joengineer656/test-claude-in-mechanical-design/DECISIONS.md

# Client Decisions Log — ALL ENGINEERS MUST READ BEFORE WORK

| Date | From | Decision / instruction |
|---|---|---|
| 2026-11-04 | Client | Wheel-legged, 2 wheels, Ascento-style legs with springs ("snappers") for jumping. |
| 2026-11-04 | Client | Model in SolidCraft. Everything 3D printed. Wheels PLA/ABS, tyre TPU with plug-and-play holes/slots (Image #1 style). |
| 2026-11-04 | Client | Design 3D-printed gearboxes for the 8308 motors. |
| 2026-11-04 | Client | Centre of mass in the middle. Room for all BOM parts. |
| 2026-11-04 | Client | Full plan + project structure before building anything. |
| 2026-11-04 | Client | Batteries: 2×3S in **series = 6S (~22.2 V)**. Check that the MKS XDrive Mini accepts 6S. |
| 2026-11-04 | Client | Wheel motors **in the wheel hub** with a planetary gearbox inside the wheel. |
| 2026-11-04 | Client | Printer: **Bambu Lab A1, 256×256×256 mm**. Split any part larger than ~250 mm. |
| 2026-11-04 | Client | Lidar: **LD19 / LD06** (~47 g). |
| 2026-11-04 | Client | **Gate A: conditional approval for P1 calculations only. NO detailed CAD until client approves P1 results (Gate B).** |
| 2026-11-04 | Client | Added Robotics & Control Engineer (balance, IMU, encoders, state estimation, motor control, jump coordination) and Electrical Engineer (battery safety, driver compatibility, power distribution, protection). |
| 2026-11-04 | Client | KV 90 is NOT confirmed. Verify 8308 specs from sources. Compare wheel ratios 4:1, 5:1, 6:1 on real data. |
| 2026-11-04 | Client | Calculate hip torque, spring rate, preload, max compression, landing loads. Study hub-motor drawbacks (unsprung mass, wheel inertia). |
| 2026-11-04 | Client | 3.95 kg budget rejected as too close to 4 kg — rework with margin. Study printed planetary gear strength; use metal gears/shafts where needed. |
| 2026-11-04 | Client | Verify MKS XDrive Mini vs 6S full charge (25.2 V) and regenerative braking. Add balancing simulation + staged prototype tests before jumps. |
| 2026-11-04 | Client | Every engineer: document assumptions, calculations, sources, open questions; record any change to design assumptions in their report. |
| 2026-11-04 | Client | Motors: **buy Eaglepower 8308 KV130** for the hips (KV90 rejected — too slow on ODrive v3.6 at 6S). |
| 2026-11-04 | Client | Mass: **use lighter (~170 g class) wheel motors**; 8308 KV130 stays on the hips only. Target ≤3.6 kg. Wheel motor to be selected in P1 (Theory + Electrical + BOM). |
| 2026-11-04 | Client | Battery: **one 6S 2200 mAh 50C pack** (replaces 2×3S in series). |
| 2026-11-04 | Client | Hip gears in **PAHT-CF** on the Bambu A1 with a hardened nozzle + filament dryer; print a test gear coupon first. |
| 2026-11-04 | Client | **CAD engineers: for bought parts (motors, drivers, sensors, Pi, lidar, camera, bearings, battery) search the web for ready 3D models (GrabCAD, manufacturer sites, McMaster, Thingiverse/Printables) and use them in the assembly instead of drawing them.** Store them in `cad/vendor/`, with each link and version in `cad/vendor/SOURCES.md`. Check every model's key dimensions against the datasheet. |
| 2026-11-04 | Client | **Mass: 4.31 kg accepted** ("not a problem"). Requirement changed from 3–4 kg to ≤4.31 kg. |
| 2026-11-04 | Client | Keep **8 J springs**. Wheel hubs in **PETG** (PLA rejected for heat). |
| 2026-11-04 | Client | **Gate B approved: P1 frozen (docs/design_targets.md rev 2). Client: "approved and start continue to end this project" — proceed P2 → release without stopping at Gate C; report progress.** |
| 2026-11-04 | Manager | O13 result: end stop changed to ≈10 kN/m TPU, engaging at 130 mm hip height, ≥30 mm travel; 40 A hip push-off mandatory; wheel gear ultimate 9 Nm. (design_targets rev 2.1) |
| 2026-11-04 | Manager | P2 layout accepted (docs/layout.md). Depth ≤300 mm applies at nominal stance; 321 mm at full crouch accepted (requirement says "around"). |
| 2026-11-04 | Manager | Layout mass 4.37 kg (+58 g, inside ±15 % estimate): P3 designers must recover it with the low-cost cuts (tyre lattice, thin covers, fewer fasteners). Target stays ≤4.31 kg. |
| 2026-11-04 | Manager | All 4 drivers on Al plates in the body; hips also use remote AS5047P/AS5048A encoder breakouts. Battery stands upright at the rear wall (CoM). Hub: Al stator carrier = hollow fixed axle, Ø14 bore, encoder on the motor axis (O11 closed). |
| 2026-11-04 | Manager | Spring stroke only 42 mm in the layout → Theory re-fits the spring (rate/crank) for 8 J. |
| 2026-11-04 | Manager | Spring re-fit: 2.7 N/mm, 2 mm music wire, OD 13, free ≈110 mm, 8 N preload, 122 N max at 42 mm; body anchor moved 49 mm outward to (94.1, 71.2) mm from the hip. **Stores 5.5 J, not the client's 8 J** (the anchor span limits it); jump 23.5 cm real at 19.8 V. Pending client objection — 8 J needs a larger layout change. Anchor design load 180 N. |
| 2026-11-04 | Manager | P3a hip gearbox accepted with conditions (docs/parts/hip_gearbox.md). CAD mass 413–435 g/side (+~0.3 kg robot, +96 g Al plates) vs 271 g budget (O10). Manager approves recovery options 1–5 (→ ≈330 g/side). Frozen gear set kept. Housing Ø122 → body gets local bulges (~4 mm front, 1–4 mm top); thigh plane +12 mm outboard. **Projected robot mass ≈4.5–4.6 kg — above the client's 4.31 kg; to be reported to the client.** |
| 2026-11-04 | Manager | Fuse: **50 A** slow-blow (electrical rev 2 follow-up; supersedes 60 A). Battery rail trim is 0…+20 mm (CoM moves ~1.7 mm per 20 mm). Spring anchors need outrigger arms on the body (anchor 37 mm ahead of the front wall, 11 mm above the top). Hip posts 4 × 49 mm from the Al plate to the side plate. |
| 2026-11-04 | Manager | **CAD method: parallel engineers use `solidcraft-cli run script.json --save part.solidcraft` (headless, own file, own process) — NOT the shared MCP/app session.** Only the final assembly uses the app. |
| 2026-11-04 | Manager | Wheel spec accepted (docs/parts/wheel_spec.md). O-W1: wheel outer face at Y 151 (+1 mm) accepted — overall width stays ≤300 only if track is reduced 2 mm: CAD engineer adjusts track to keep ≤300. O-W2: 6806 pair SF 1.3 one-shot static accepted for rare fault, Structural to confirm. O-W3: fin area 60 cm² accepted for ~2 A real duty (continuous limit lower than 7 A) — Thermal to re-check. Wheel module ≈600 g vs 536 g: apply the spec's cuts. |
| 2026-11-04 | Manager | **Structural review of hip gearbox FAILED the single 6806** (fault landing 2.13 kN radial + 22 Nm moment: ball SF 0.78, tilt ≈4.8°). **Decision: second hip output bearing on an outboard stub at y≈108 (arch), ≥21 mm spacing with the thigh plane between the two bearings** (each ≈1.1 kN, SF 2.7). Thigh hex socket must be PAHT-CF or steel-lined (PETG SF 0.78). Skirt needs stiffening (SF 1.41 → ≥1.5). Body side plate needs a seat to take the radial load from the Al plate (PETG SF 0.8 otherwise). M3 washers mandatory on stack bolts. New load case: lateral slide landing 1.0–1.7 kN axial (cover lip SF 1.1 → strengthen). M4 insert pull-out in PAHT-CF needs a test coupon. Load cases S1–S13 in docs/analysis/structural.md §3 apply to legs, hub, body. |
| 2026-11-04 | Client | **Weight and diameter increases are NOT a problem. Priority = finish the project. Do not stall on mass/size limits; choose the stronger/simpler design and just report the final numbers.** (Mass limit and 300 mm width become soft targets; no more client questions about mass.) |
| 2026-11-04 | Manager | Leg spec accepted (docs/parts/leg_spec.md) with fixes: shank gets a 2 mm Al plate (SF 1.12 → 1.9); knee/links built as double-plate clevis (symmetric) to avoid the ~48 Nm offset couple; spring-to-B-pin clearance −0.3 mm at crouch must be fixed (offset the spring or widen the B pin spacing, parameters may move ±10 mm); pins Ø8 steel with bronze bushings; spring anchor on a tower bracket; depth 302 / 323 mm accepted (soft limit). |
| 2026-11-05 | Manager | Wheel CAD accepted (docs/parts/wheel.md). Spur gears (herringbone loft hangs the kernel; zero tooth overlap verified); chevron tread → straight grooves; width ≈301 mm; wheel module ≈601 g printed. Open: neck wall 1.4 mm (must be thickened to ≥2.5 mm), outboard bearing retention (add a retaining ring/cap). |
| 2026-11-05 | Manager | Body CAD accepted (docs/parts/body.md): 611 g solid (≈450–500 g sliced). Hip bulge Ø140, front reach x 99.6. Battery raised 9.4 mm, Pi moved 20 mm forward. Charge port in the lid, XT60 charge lead bypasses fuse and switch BY DESIGN — must be a keyed charge-only connector (XT60 with a protective cap), never used as a load connector; Electrical to confirm. Open: hip posts vs skirt ears (hip gearbox rotates ears), ear relief in hip seat, outboard arch bracket (add after hip gearbox final envelope). |
| 2026-11-05 | Manager | Wheel fixes done: neck Ø38 (wall 3.4 mm), shank foot hole Ø38.2 (leg must match), circlip groove for the outboard bearing race. Module ≈606 g printed. |
| 2026-11-05 | Manager | Leg CAD accepted with open items (docs/parts/leg.md): ≈945 g/leg solid (1.7–1.9 kg both legs vs 254 g in layout). B pin moved to (46,30); spring axis y 110. **Wheel (R85) hits hip housing/arch below hip height ≈137 mm → minimum hip height raised to 140 mm (end stop engages ≥140), stroke becomes 140–289 mm.** B-pin 2 kN path (arch/posts/beam) undersized (SF 1.3) → box beam or tie into body frame (needs fix). Thigh angle shifted (nominal −33°): check gearbox homing tab. **Mass now far above the layout; function (20 cm jump, 12 km/h) must be re-verified at the real mass — client accepted weight growth, not loss of function.** |
| 2026-11-05 | Manager | **Actual CAD mass roll-up: 6.86 kg solid, ≈6.4 kg sliced (range 6.0–6.9 kg) vs 4.31 kg accepted. Unsprung 0.84–0.93 kg/side. CoM ≈ +11 mm forward (approx).** Theory must re-verify 20 cm jump, 12 km/h and balance at 6.4 kg with hip height ≥140 mm. |
| 2026-11-05 | Gearbox CAD | Rev 1: 2nd 6806 on arch (bearings 21 mm apart, thigh plane y 94-103, arch y 104-116 on housing ear at world 105 deg); skirt windows 10x10 + 6 ribs; cover lip 2 mm; ears rotated to world 15/75/105/165/195 deg (clear of body posts); thigh clamp = 1 central M4 insert (3 face inserts removed); skirt top lip dropped; mass ~500 g/side + 80 g plate; O10, OQ-2 closed; insert pull-out coupon open. |
| 2026-11-05 | Manager | Hip gearbox rev 1 accepted (docs/parts/hip_gearbox.md): bearings at y 87.5 / 108.5; thigh plane y 94–103; arch y 104–116 (X 1.6–51.5, Z 256.5–351.6); ears at world 15/75/105/165/195° (≥30° from body posts, max r 66.8, x 94.8 < 99.6); ≈500 g/side + 80 g Al plate. Skirt top lip dropped, thigh clamp = one central M4 insert. **All four part CADs done → full assembly in the SolidCraft app next.** |
| 2026-11-05 | Manager | **Theory re-run at 6.0 kg (partial): 20 cm jump FAILS** (16.1 cm real with springs at 19.8 V, 19.1 cm at 22.2 V); stiffer springs do not rescue it (4.1 N/mm → 17.1 cm). **Hip ratio 6:1 passes (21.6 cm).** Fault landing (motors off) 30 Nm vs 16 Nm hip gearbox limit also FAILS. 12 km/h and balance PASS. Standing needs 3.8 Nm/leg; single-leg climb 8.5 Nm/leg (> 5.7 Nm cont, brief use only). Manager direction: Materials designs a 6:1 compound set that fits the existing hip housing; mass trim of the legs to follow if Theory's 6.4/6.9 kg results still fail. |
| 2026-11-05 | Manager | **Theory final re-run (CAD mass 6.0–6.9 kg): 20 cm jump fails ≈16 cm real at 19.8 V at EVERY mass tested (4.4–7.0 kg) — mass is NOT the cause; the cause is the raised minimum hip height (140 mm, stroke 150 mm) with speed-limited 8:1 hips.** (Correction of the manager's earlier remark that cutting leg mass helps the jump.) Fix: **hip gearbox 6:1** → 21.4 cm (6.0 kg 21.6, 6.9 kg 20.9), hip peak 13 Nm < 16 Nm. Also FAIL at 6.4 kg: controlled landing 16.7 Nm (limit 16), one-wheel-first 24 Nm, motors-off 29 Nm, knee pin 2.6 kN vs 2.0 kN design load. PASS: 12 km/h (19.2 km/h), balance (41–45° tilt), standing 4.1 Nm/leg, single-leg climb 5.0 Nm (5.8 Nm at 6.9 kg, marginal). Needed: torque limiter/slip or compliant stop for motors-off landings, stronger knee-pin load path. |
| 2026-11-05 | Manager | **Hip gearbox changes to 6:1** (materials_gears.md 'Hip 6:1 option'): sun 28 T m1.0 spur b15.5 (x −0.146); planet big step 40 T m1.0 spur b14 (x −0.097), tip r 54.7 mm; ring 63 T m1.5, small step 18 T m1.5, carriers, pins, bearings, housing UNCHANGED. Centre distance 33.75 both stages. Sun SF 1.78, ring mesh 2.26 at 20 Nm / 50 °C. Hip peak 13 Nm at 40 A. Fault landing ≈17 Nm vs 20 Nm design torque (capacity 36 Nm, SF 2.1): **accepted — design torque 20 Nm governs (theory's 16 Nm was a conservative target)**, still add the compliant stop. Design targets updated: hip 6:1. |
| 2026-11-05 | Gearbox CAD | 6:1 implemented in CAD: sun 28T / planet big 40T m1.0 (x -0.146/-0.097); planets 2,3 spun on their pins by 120 and 60 deg (Zs/3 not integer, raster check: 0 interference, min gap 0.056 mm); swept R 54.7; -13 g/side (~484 g/side + 80 g plate). STL/STEP/exploded updated. |
| 2026-11-05 | Manager | Hip 6:1 in CAD (hip_gearbox.md rev 1.1): ≈484 g/side + 80 g plate, planet swept R 54.7 vs housing inner R 58.5. **Assembly note: Zs=28 not divisible by 3 → planets 2 and 3 must be spun on their pins by 120° and 60° (mark the planets; same part, different assembly orientation).** 2D raster: 0 interference; planet-sun flank gap ≥0.056 mm (verify by test print). hip_gearbox.step replaced → assembly must use the new file. |

## 2026-11-05 Assembly review decisions (Manager) — see docs/assembly.md section 6
| # | Decision |
|---|---|
| A1 | Assembly result: 303.4×302×403 mm, 6.96 kg solid / 6.33 sliced, CoM +22 mm ahead of axle (FAIL, target ±5), 17 mismatches M1–M17. |
| A2 | M1: the LEG's outer bearing/arch plate stays; the hip gearbox deletes bearing 2, Ø30 journal extension and HG_Arch bar/ring (keeps hex + clamp insert). Structural re-checks SF. |
| A3 | M8: minimum hip height stays 140 (jump); BODY notches side plates/tray around the axle path (option b). |
| A4 | CoM: Leg+Theory re-fit the 4-bar nominal pose so the hip is 10–15 mm ahead of the axle (not 37). Interim: controller pitch trim. Client allows weight/size growth. |
| A5 | M3: sleeve inner 26.3 A/F; gearbox homing tab/stop moved to -33.19° (thigh angle changes with A4 → use final angle). M4 +1 mm thigh plane; M10–M12 +0.5–1 mm spacings. |
| A6 | M7: the body spring dowel is deleted; the 180 N path = leg arch plate + posts + beam, tied to the body frame; Structural decides box beam. |
| A7 | M14 LD19 = Ø54×35, mast plate Ø60. M13 resistors/Pi/camera moved per assembly.md. |
| A-GB | Hip gearbox (2026-11-05, rev 3) | M1/M3/M4 done in CAD: bearing 2, Ø30 journal ext. and HG_Arch deleted (clamp insert hole now z 55-65 in the hex); homing tab at 213.19 deg local (thigh -33.19; re-check vs leg_interfaces_rev2.md, not yet written); cover boss trimmed to y 92 (lip now 1 mm). Mass 434 g/side (514 with plate). M6 ear rotation not done (Body arm decision pending; needs Ring/Cover/Skirt rebuild). **Structural: the outer leg bearing alone does not relieve bearing 1 (thigh load enters at the hex 11.5 mm from it); need a short (3-4 mm) steel sleeve at the inboard end of the hub with the rest relieved >= 0.5 mm: then LC-A/B/C pass, LC-D marginal (ball 1.14, seat 1.42). 1 mm cover lip fails at 1.7 kN axial (0.73): keep a 2 mm lip (thigh +1 mm instead of the trim) or add a circlip.** |
| A8 | Leg rev 2 (Manager-accepted): B pin (39,31), anchor (97.4,70.9); nominal thigh angle -24.26°; hip 10.6 mm ahead of axle; CoM +2.0 mm solid / +0.9 mm sliced (target ±5, PASS). Axle is 26 mm further forward than rev 1 → Body re-derives axle notch. |
| A9 | Spring changed to 3.5 N/mm, 15 N preload, peak 169 N, 4.0 J/leg (8.1 J both = the client's 8 J request, met). Jump 20.2 cm real at 6.4 kg/19.8 V (19.7 at 6.9 kg: marginal). Materials/Electrical must confirm wire stress (~740 of ~900 MPa) and order the spring. |
| A10 | Thigh sleeve 4 mm long (y 94–98), pocket relieved; thigh plane y 94–104; 6061 box beam 40×8.5×2 tied to body with 2×M5; leg exports now world coordinates (left), right = true mirror. |
| A11 | Client: "skip the thermal test" → P4 thermal re-review at the final CAD is skipped. Existing thermal.md design rules (finned axle, fan, vents, NTC per motor) stay as is, unverified at the new mass. |
| A12 | Final sim (2D/1D, not hardware): balance + 12 km/h PASS at 6.4/6.9 kg; jump 21.7/21.2 cm from 22.2 V rest, 19.9/19.5 from 20.5 V → jump gate rest voltage ≥21.5 V (22.0 aged). Controller must add integrator/pitch trim and IMU zero at CoM line. Spring spec: Ø2.00 A228, OD 13, ~34 active coils, 3.5 N/mm, 15±3 N, free 116 mm, reduced closed hooks ID 6.5, stress-relieved; SF 1.19 (thin) → order 6, replace after 500 jumps; fallback Cr-Si wire. Test plan rev 6 in control.md §3.7. |
| A13 | Structural Rev 2 formal check: all loaded leg parts must be PAHT-CF (PETG fails). Manager accepts changes C1–C11 (structural.md): Al shank plate 3→6 mm; C pad → S355 Ø21 stand-off Ø36 flange 4×M5; thigh boss R17→R20 + DU-type bush; Ø38×4 round steel sleeve; posts Ø16→Ø18; beam foot 47×32 with 4×M5 through-bolts + backing plate, beam height 12; hip bearing 1 6806→6906; body post base seat y 40 + D16.4×10 collar; knee pin capped 2.0 kN by compliant stop. Lateral-slide fault case (LC-D) accepted as abuse case (no fracture required). FEA of shank + arch plate still to do before release. |
| A14 | Client: "after both finished stop the project until I told you" → when the Body/Gearbox and Assembly rev 2 agents finish, NO further work or agents until the client says continue. Next planned step then: assembly rev 3 with Leg 2b + Body/Gearbox structural changes, Theory CoM/jump re-run, FEA, release. |
| A15 | Assembly rev 1 (rev 2 parts, before Leg 2b/structural changes): 13 PASS, M3 + M13 FAIL, CoM +1.6/+0.4 mm PASS, size 308.9×302×403. Manager decision: IMU rule relaxed to ≥30 mm from motor (ICM-42688 has no magnetometer; ±30 mm of CoM kept). Fix list queued (not started, project paused per A14): sleeve/pocket -5.8°; Pi plate notch 25×4; camera +1.5 mm; extension stop ≥20° further out; front cover lip widen hip notch; M16 confirm. |
| A16 | Client: "stop everything" → all agents stopped, project paused until the client says continue. |
