joengineer656/test-claude-in-mechanical-design/51fNBSpzq5L.jpg

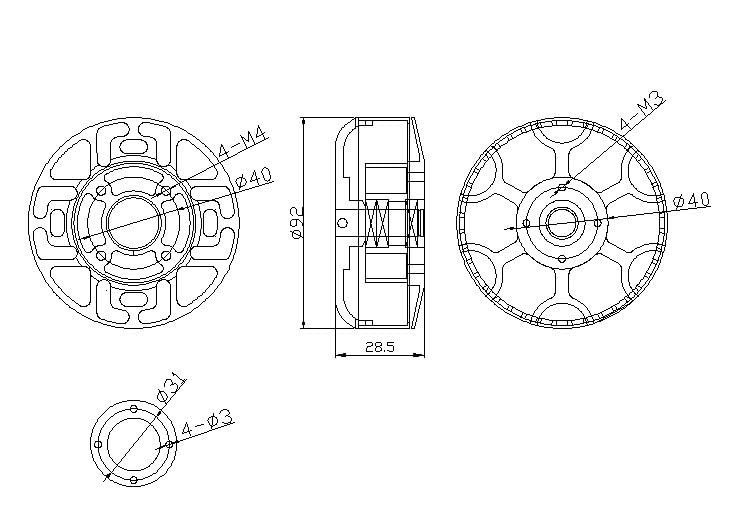
51fNBSpzq5L.jpg
