joengineer656/test-claude-in-mechanical-design/docs/screenshots/body_left.png

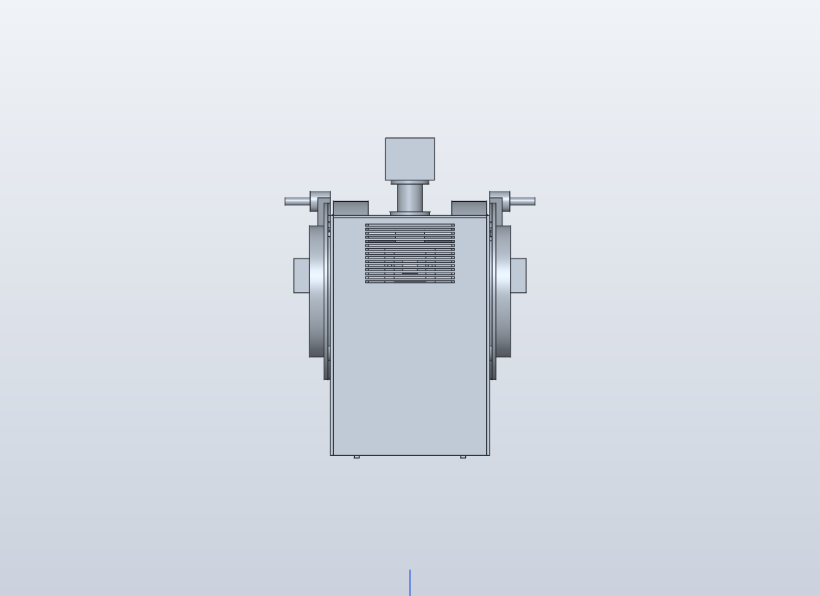
docs/screenshots/body_left.png
