joengineer656/test-claude-in-mechanical-design/docs/screenshots/body_top.png

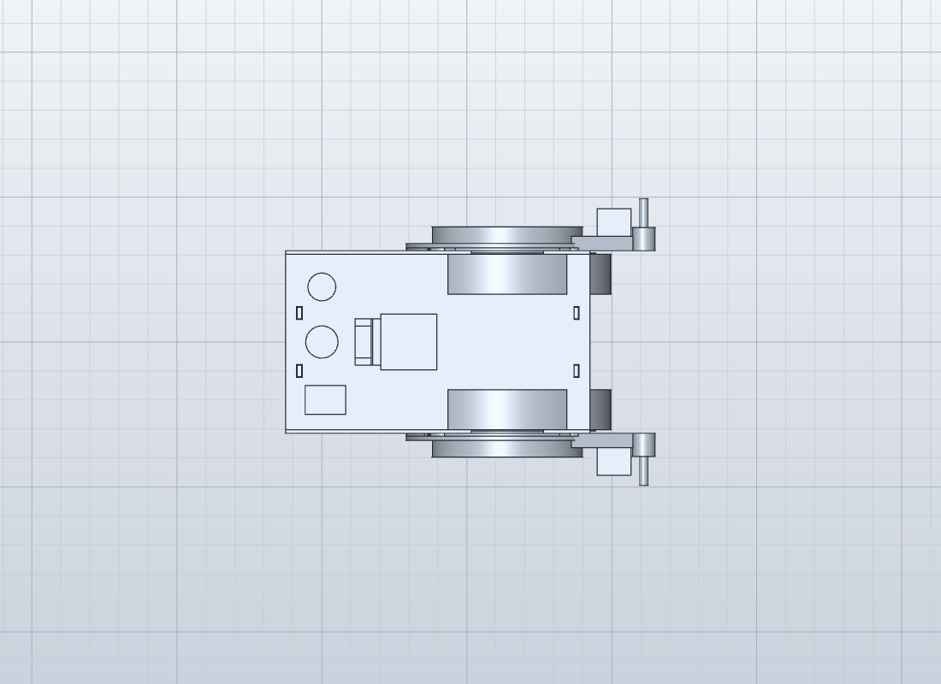
docs/screenshots/body_top.png
