joengineer656/test-claude-in-mechanical-design/docs/screenshots/hip_gearbox_arch.png

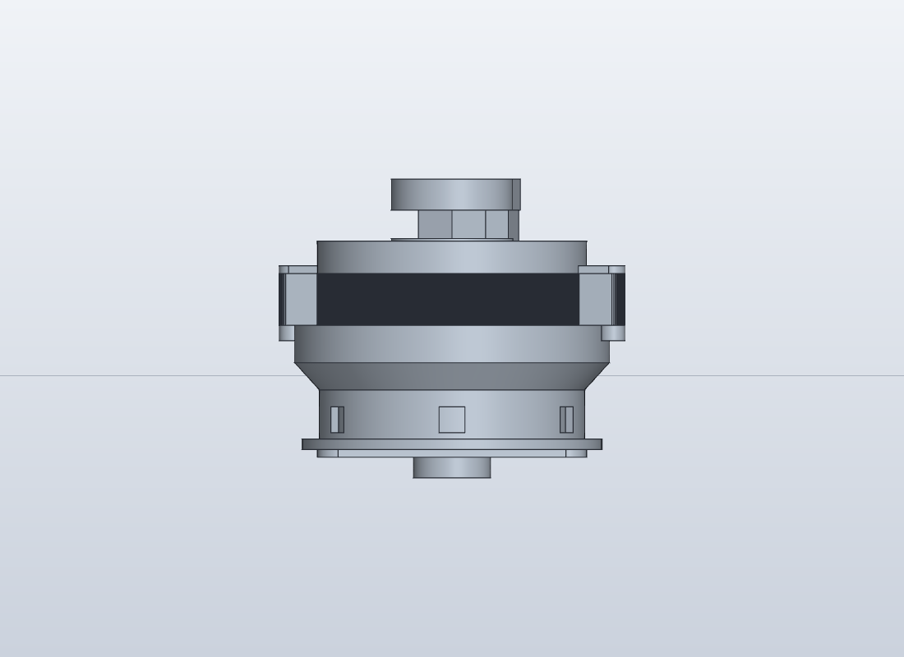
docs/screenshots/hip_gearbox_arch.png
