joengineer656/test-claude-in-mechanical-design/docs/screenshots/hip_gearbox_ring_stage_z30.png

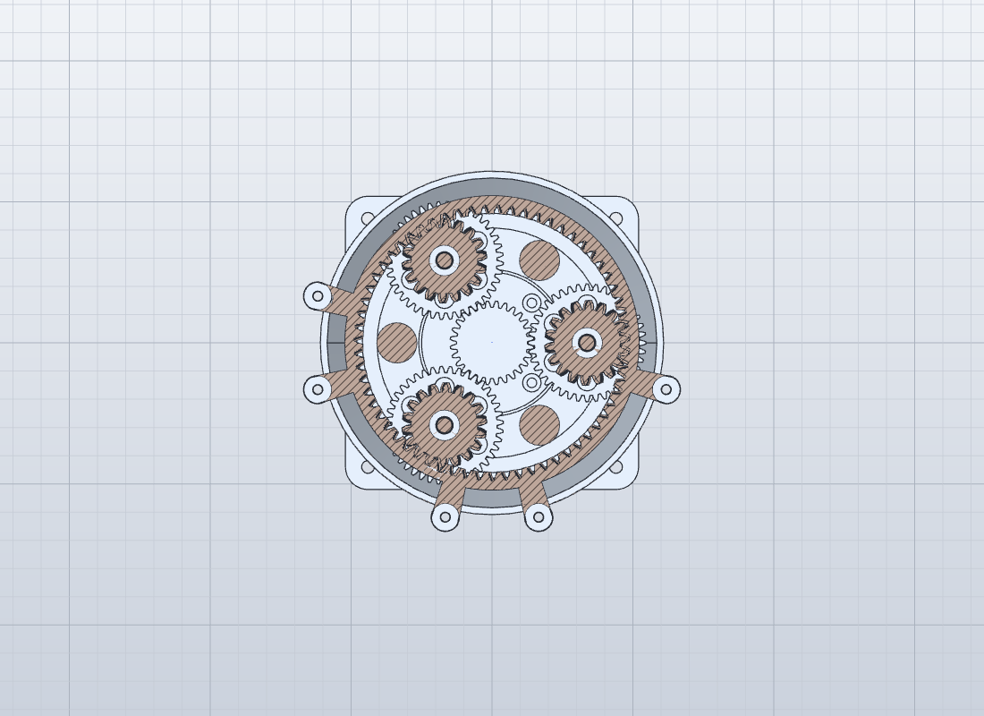
docs/screenshots/hip_gearbox_ring_stage_z30.png
