joengineer656/test-claude-in-mechanical-design/docs/screenshots/leg_101_iso.png

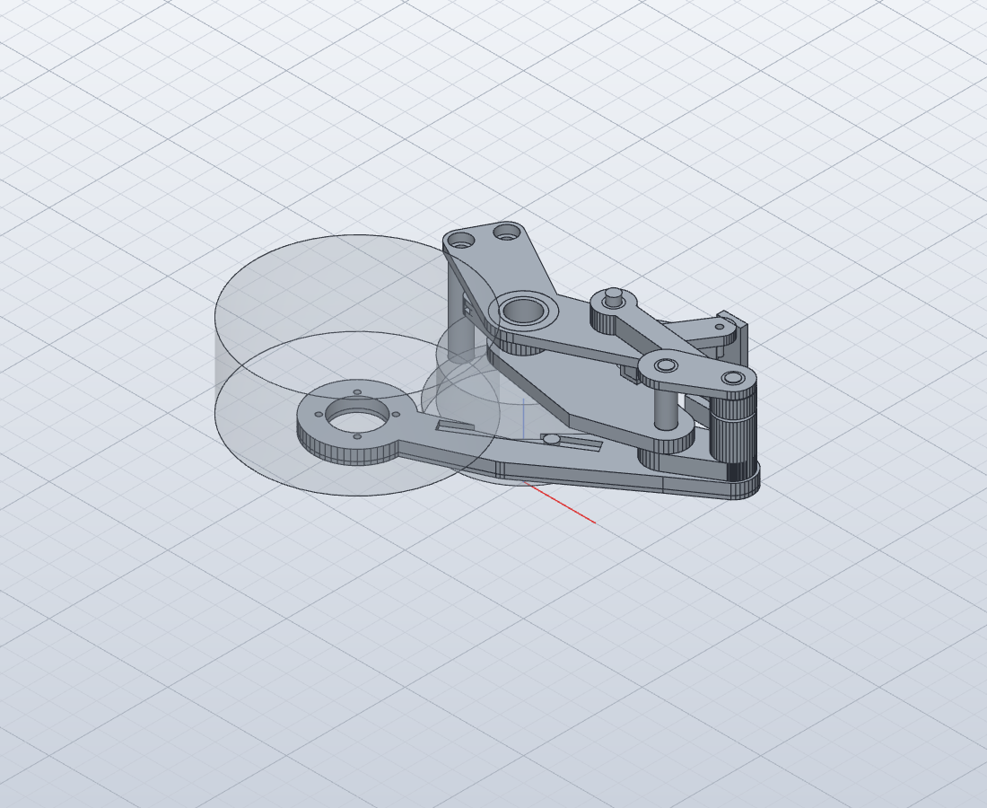
docs/screenshots/leg_101_iso.png
