joengineer656/test-claude-in-mechanical-design/docs/screenshots/leg_101_plane.png

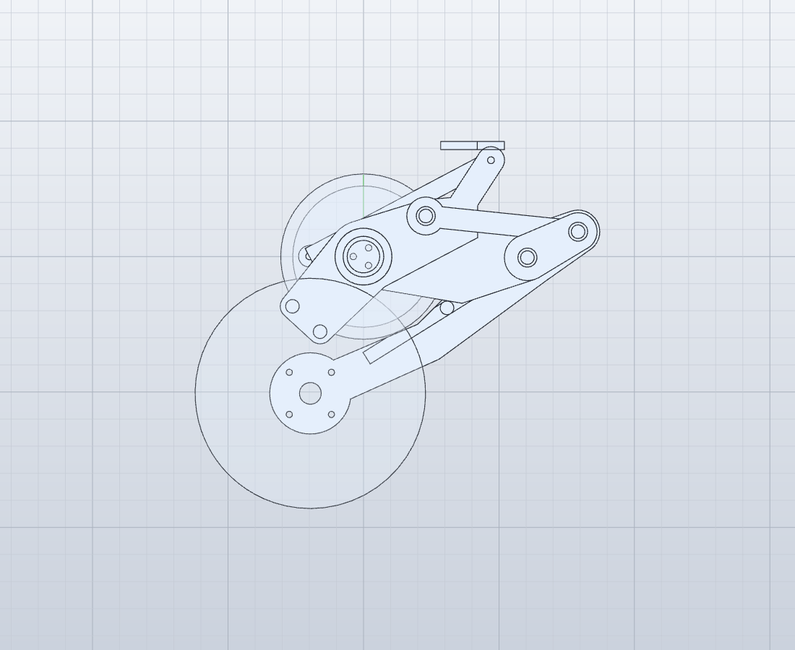
docs/screenshots/leg_101_plane.png
