joengineer656/test-claude-in-mechanical-design/docs/screenshots/leg_195_plane.png

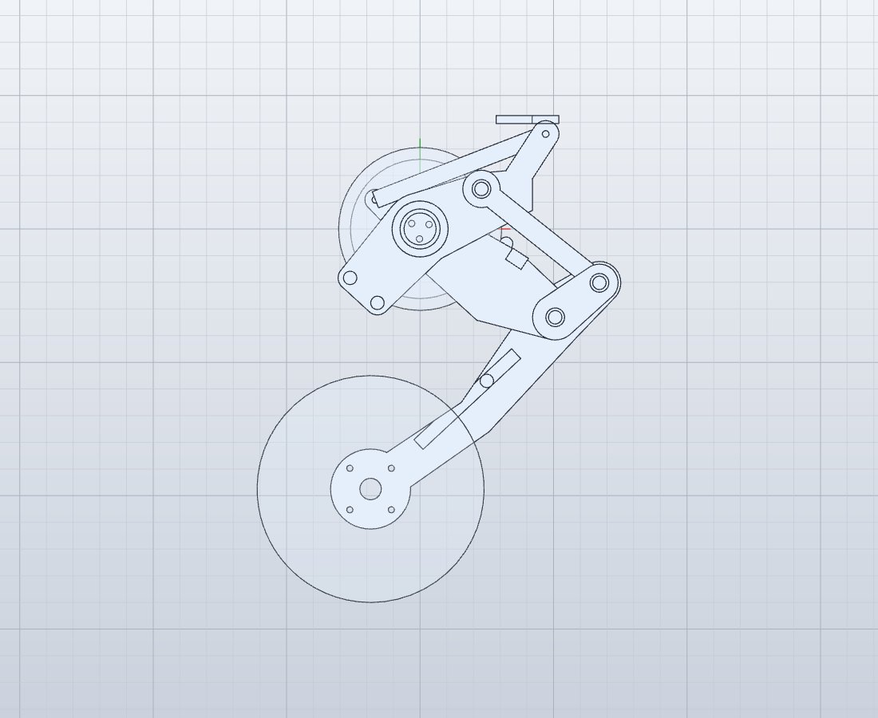
docs/screenshots/leg_195_plane.png
