joengineer656/test-claude-in-mechanical-design/docs/screenshots/master_layout_front.png

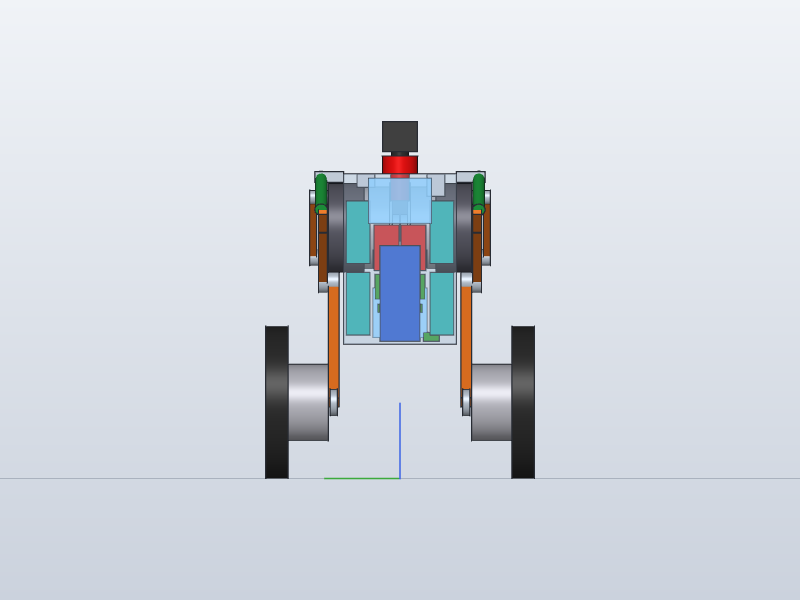
docs/screenshots/master_layout_front.png
