joengineer656/test-claude-in-mechanical-design/docs/screenshots/master_layout_side_crouch.png

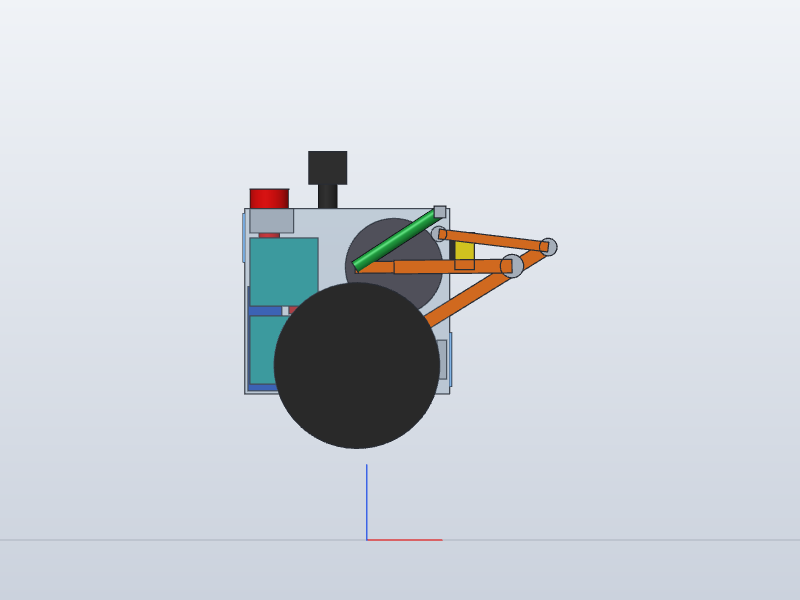
docs/screenshots/master_layout_side_crouch.png
