joengineer656/test-claude-in-mechanical-design/docs/screenshots/wheel_gears_z56.png

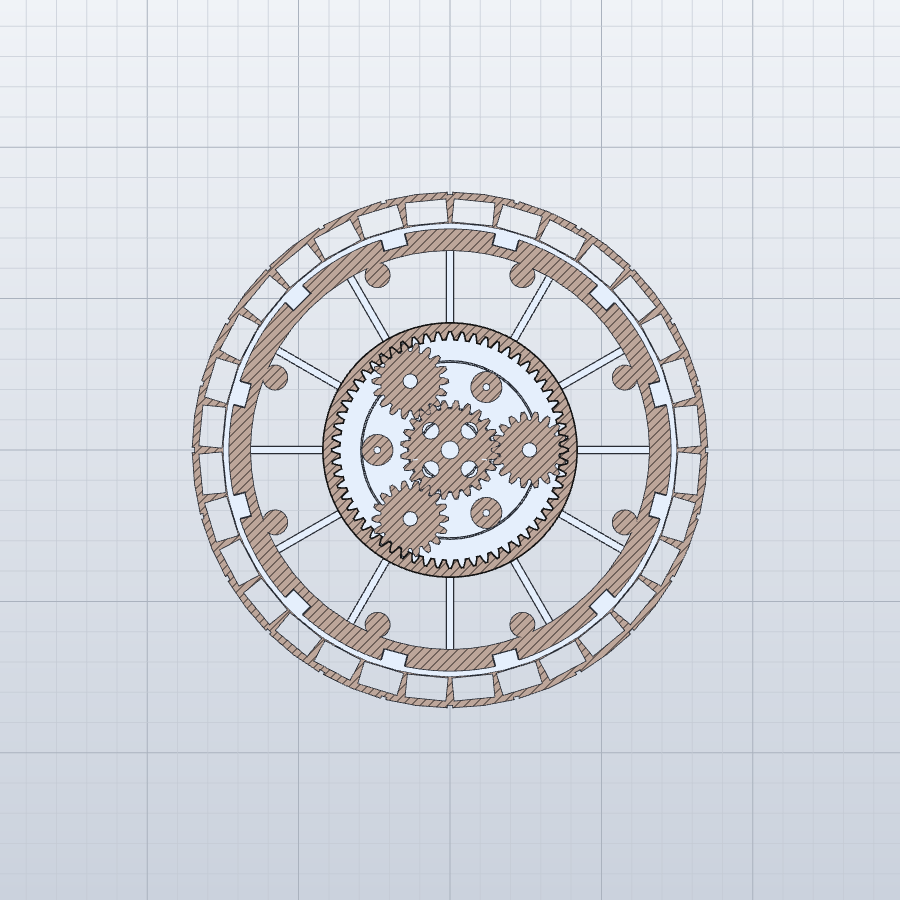
docs/screenshots/wheel_gears_z56.png
