joengineer656/test-claude-in-mechanical-design/exports/step/leg_plate.step

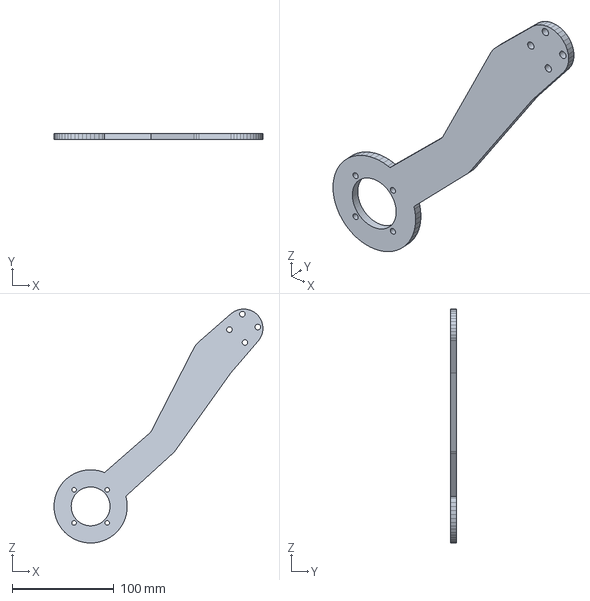
[picture p25: CAD file, 2026-11-05]
exports/step/leg_plate.step
205.5 x 6.00 x 230.1 mm
