joengineer656/test-claude-in-mechanical-design/exports/stl/body/B7a_PiDeck.stl

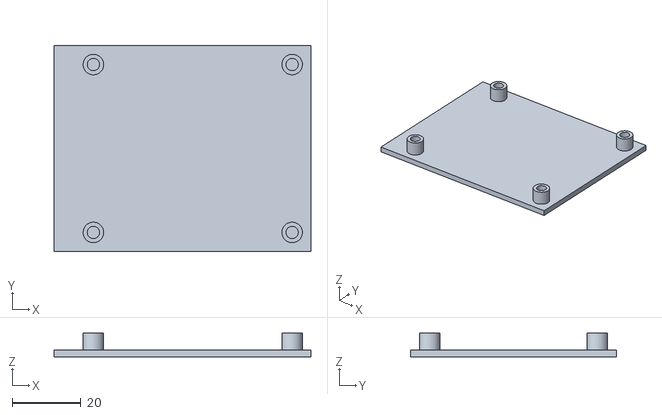
[picture p26: CAD file, 2026-11-05]
exports/stl/body/B7a_PiDeck.stl
75.0 x 60.0 x 7.00
