joengineer656/test-claude-in-mechanical-design/exports/stl/hip_gearbox/HG_Skirt_L.stl

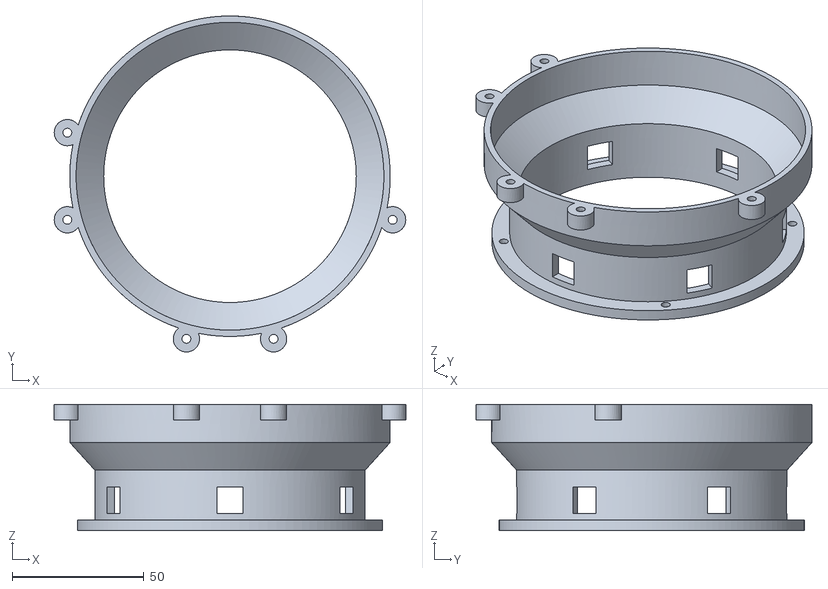
[picture p27: CAD file, 2026-11-05]
exports/stl/hip_gearbox/HG_Skirt_L.stl
133.6 x 127.7 x 48.0
