joengineer656/test-claude-in-mechanical-design/exports/stl/leg/posts.stl

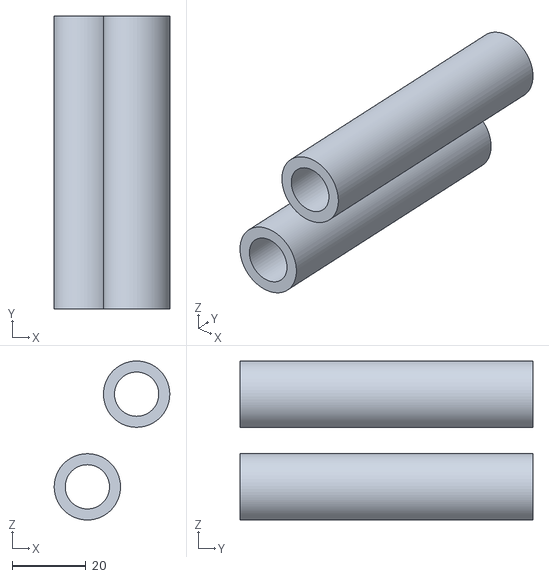
[picture p28: CAD file, 2026-11-05]
exports/stl/leg/posts.stl
31.4 x 79.5 x 43.1
