joengineer656/test-claude-in-mechanical-design/exports/stl/wheel/bought.stl

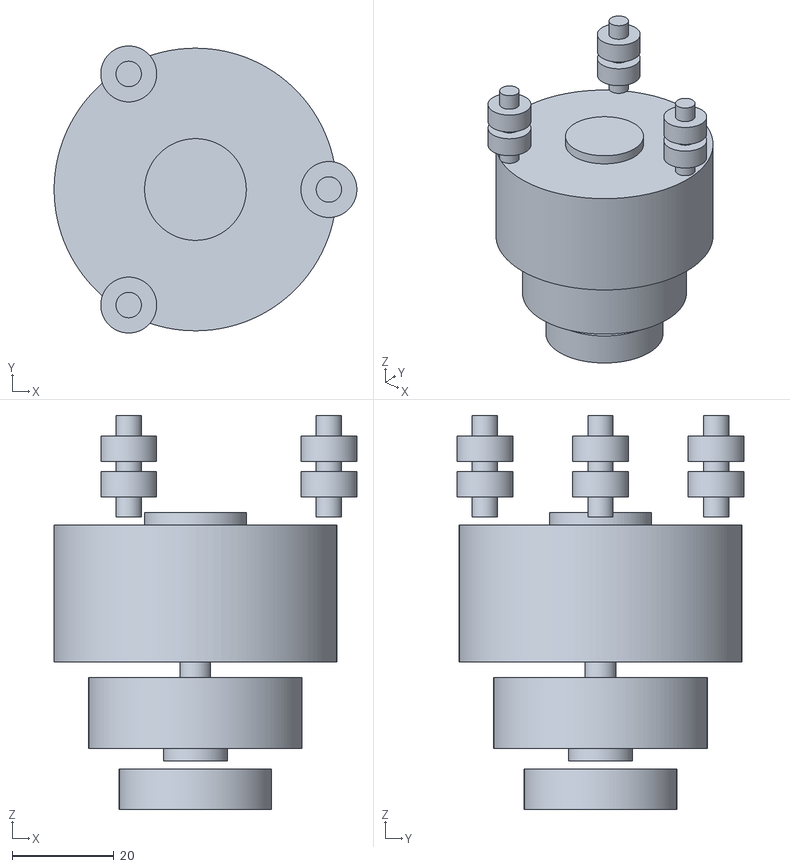
[picture p29: CAD file, 2026-11-05]
exports/stl/wheel/bought.stl
59.5 x 56.5 x 77.5
