joengineer656/test-claude-in-mechanical-design/exports/step/body.step

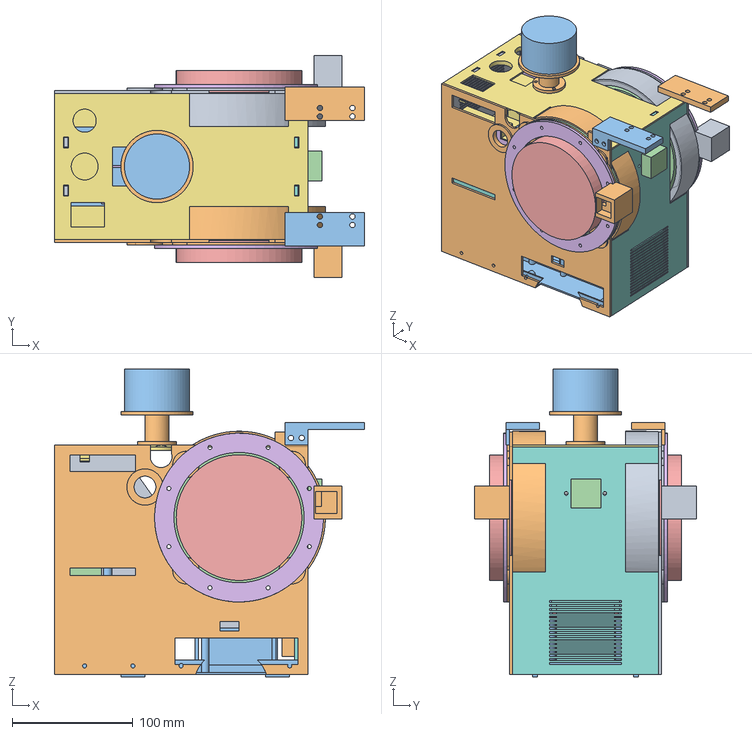
[picture p30: CAD file, 2026-11-05]
exports/step/body.step
257.0 x 184.0 x 255.0 mm
