joengineer656/test-claude-in-mechanical-design/exports/stl/body/B1T_Tie_R.stl

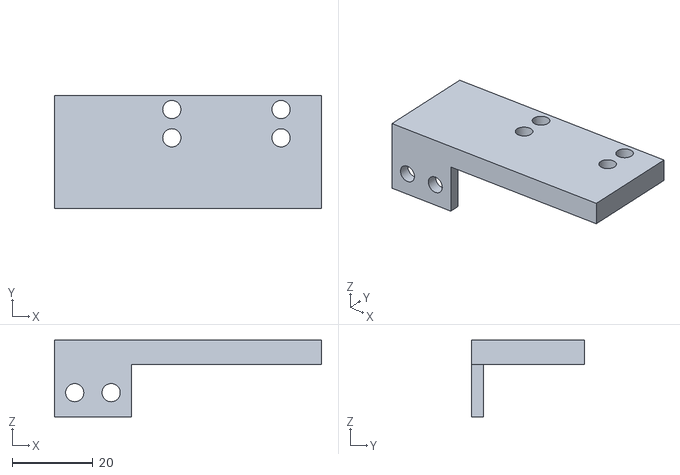
[picture p31: CAD file, 2026-11-05]
exports/stl/body/B1T_Tie_R.stl
66.0 x 28.0 x 19.0
