joengineer656/test-claude-in-mechanical-design/exports/stl/hip_gearbox/HG_Planet_x3.stl

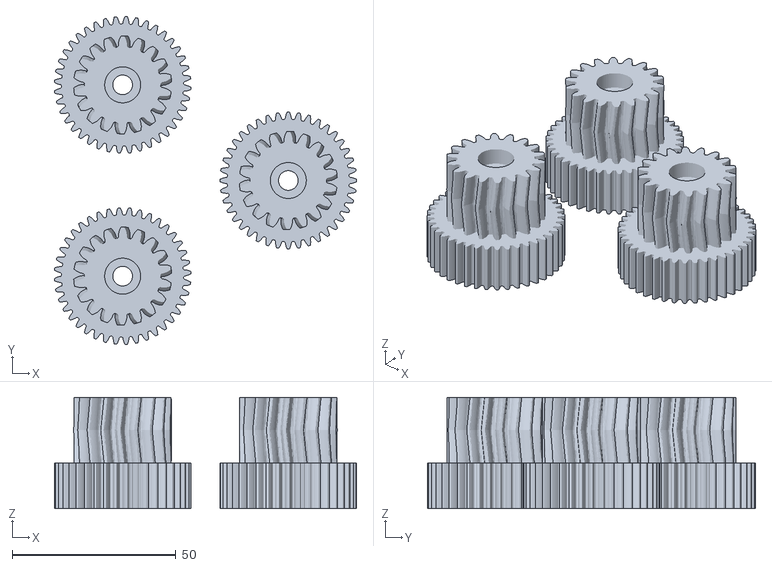
[picture p32: CAD file, 2026-11-05]
exports/stl/hip_gearbox/HG_Planet_x3.stl
92.4 x 100.2 x 34.0
