joengineer656/test-claude-in-mechanical-design/exports/stl/leg/thigh.stl

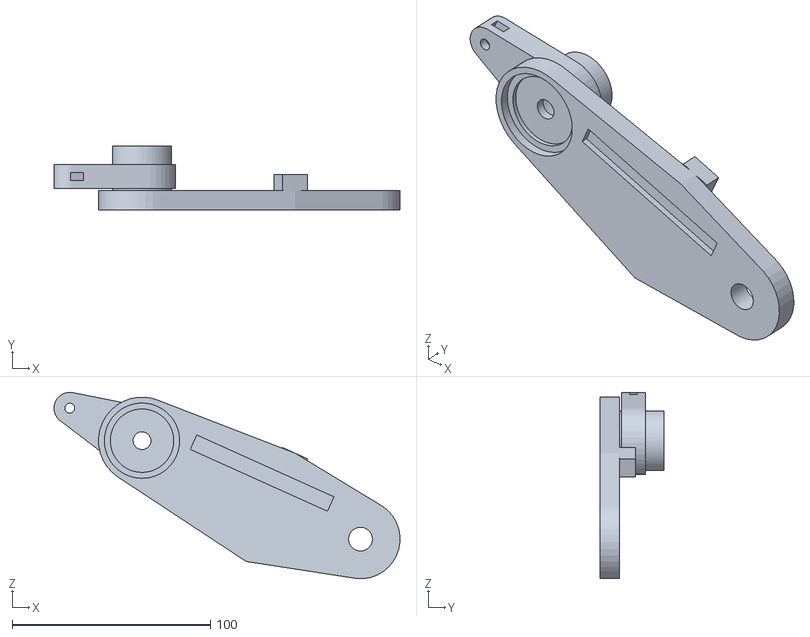
[picture p33: CAD file, 2026-11-05]
exports/stl/leg/thigh.stl
174.7 x 32.5 x 94.1
