joengineer656/test-claude-in-mechanical-design/exports/stl/wheel/carrierB.stl

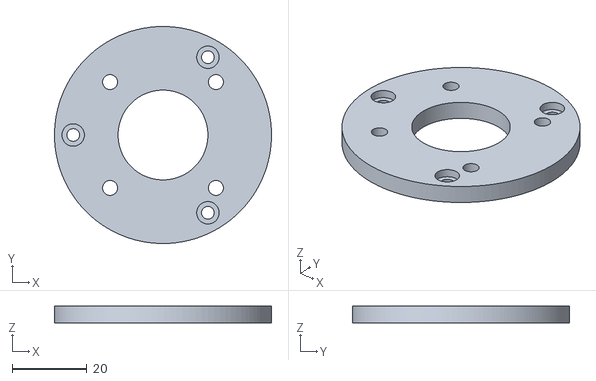
[picture p34: CAD file, 2026-11-05]
exports/stl/wheel/carrierB.stl
58.0 x 58.0 x 4.50
