joengineer656/test-claude-in-mechanical-design/exports/stl/body/B4_Front.stl

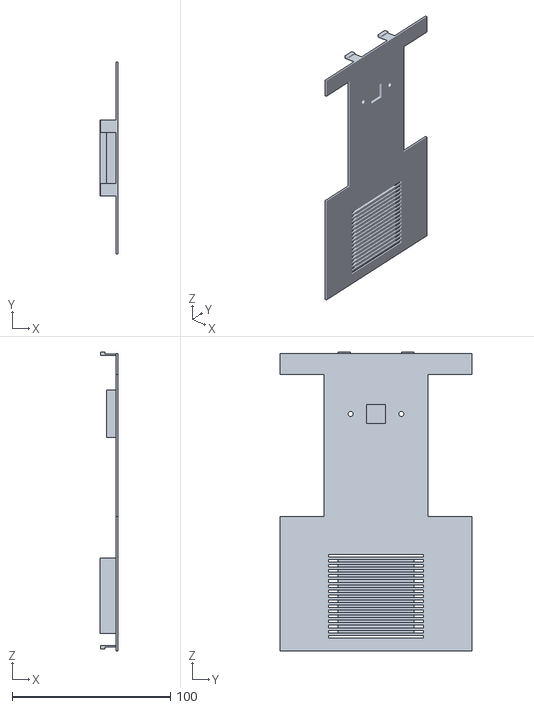
[picture p35: CAD file, 2026-11-05]
exports/stl/body/B4_Front.stl
11.2 x 121.2 x 189.2
