joengineer656/test-claude-in-mechanical-design/exports/stl/hip_gearbox/HG_CarrierOut.stl

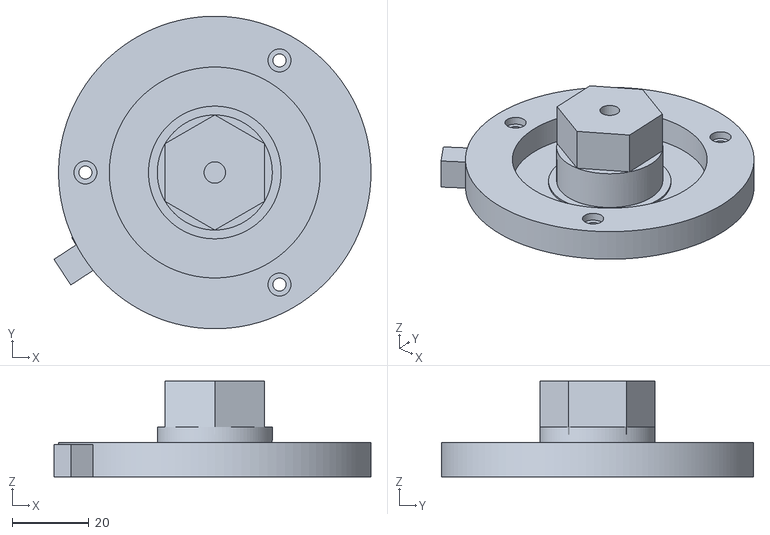
[picture p36: CAD file, 2026-11-05]
exports/stl/hip_gearbox/HG_CarrierOut.stl
82.7 x 81.5 x 25.0
