joengineer656/test-claude-in-mechanical-design/exports/stl/leg/bplate.stl

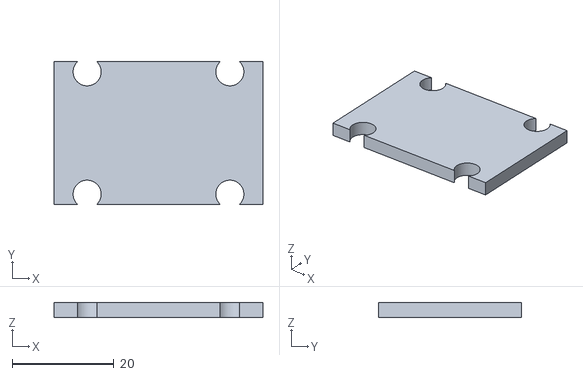
[picture p37: CAD file, 2026-11-05]
exports/stl/leg/bplate.stl
41.0 x 28.0 x 3.00
