joengineer656/test-claude-in-mechanical-design/exports/stl/wheel/axle.stl

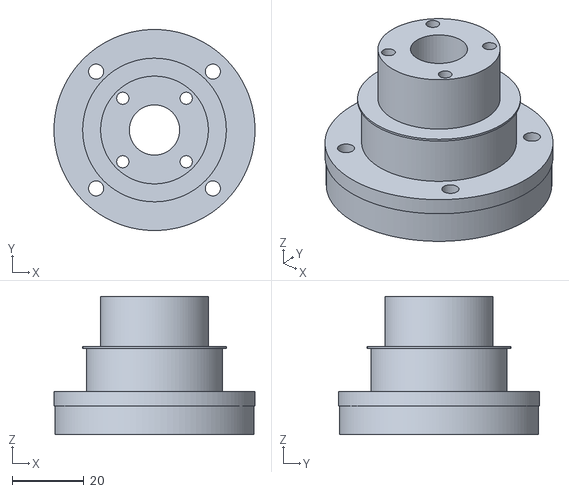
[picture p38: CAD file, 2026-11-05]
exports/stl/wheel/axle.stl
56.0 x 56.0 x 38.5
