joengineer656/test-claude-in-mechanical-design/exports/stl/body/B1_Side_R.stl

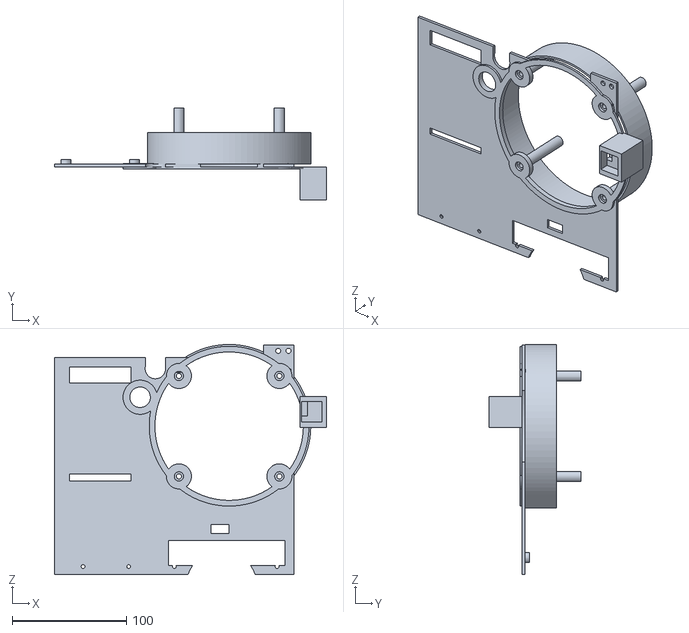
[picture p39: CAD file, 2026-11-05]
exports/stl/body/B1_Side_R.stl
238.3 x 80.5 x 201.6
