joengineer656/test-claude-in-mechanical-design/exports/stl/wheel/carrierA.stl

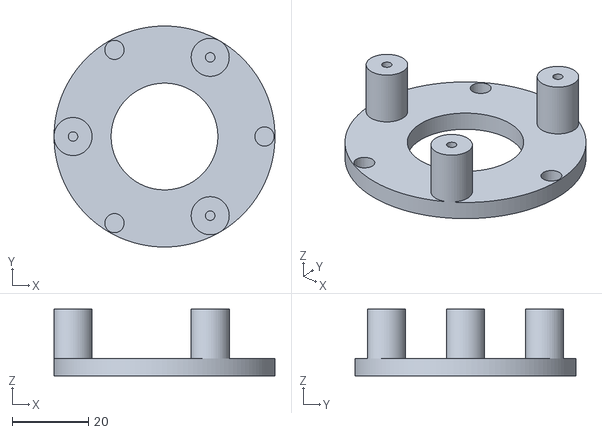
[picture p41: CAD file, 2026-11-05]
exports/stl/wheel/carrierA.stl
58.0 x 58.0 x 17.5
