joengineer656/test-claude-in-mechanical-design/exports/step/leg_coupler.step

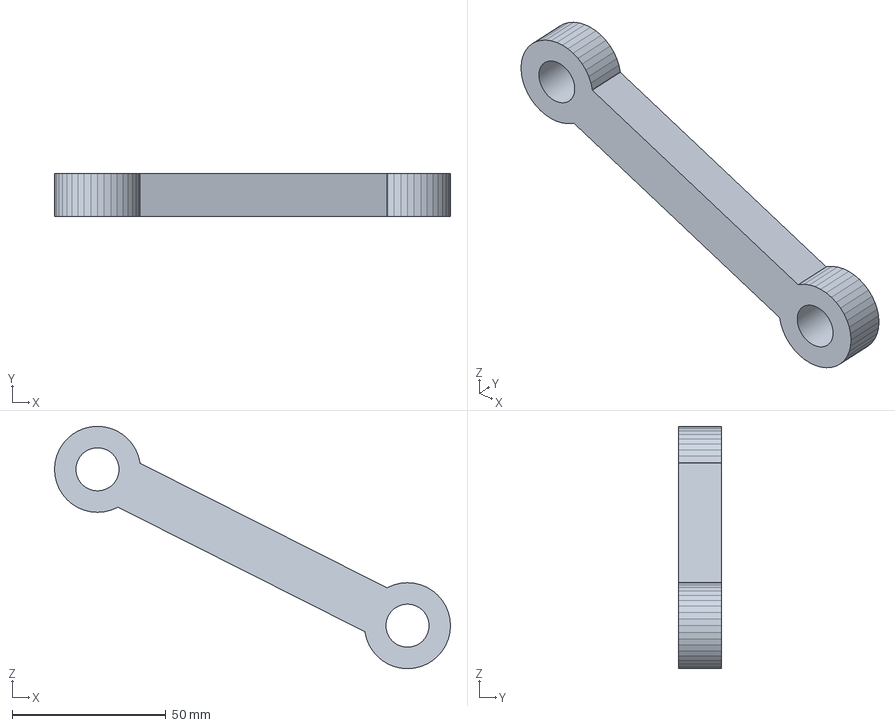
[picture p42: CAD file, 2026-11-05]
exports/step/leg_coupler.step
128.9 x 14.0 x 78.9 mm
