joengineer656/test-claude-in-mechanical-design/exports/stl/body/B6_Mast.stl

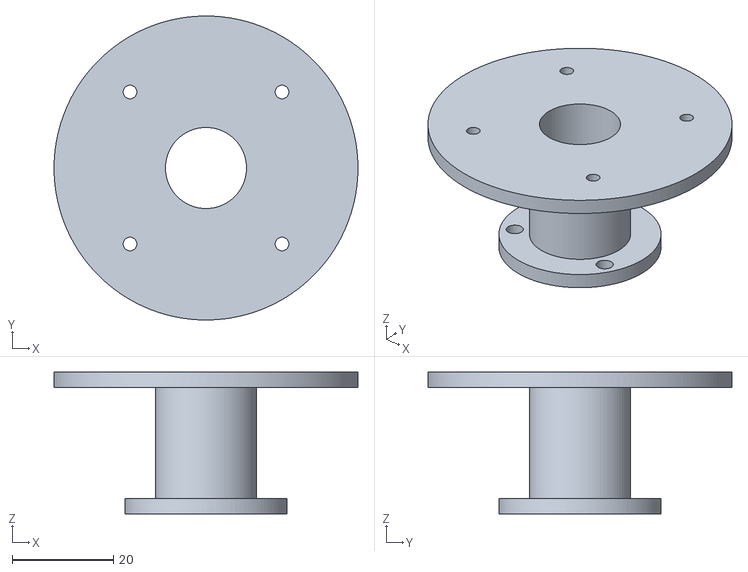
[picture p43: CAD file, 2026-11-05]
exports/stl/body/B6_Mast.stl
60.0 x 60.0 x 28.0
