joengineer656/test-claude-in-mechanical-design/exports/stl/hip_gearbox/HG_CarrierIn.stl

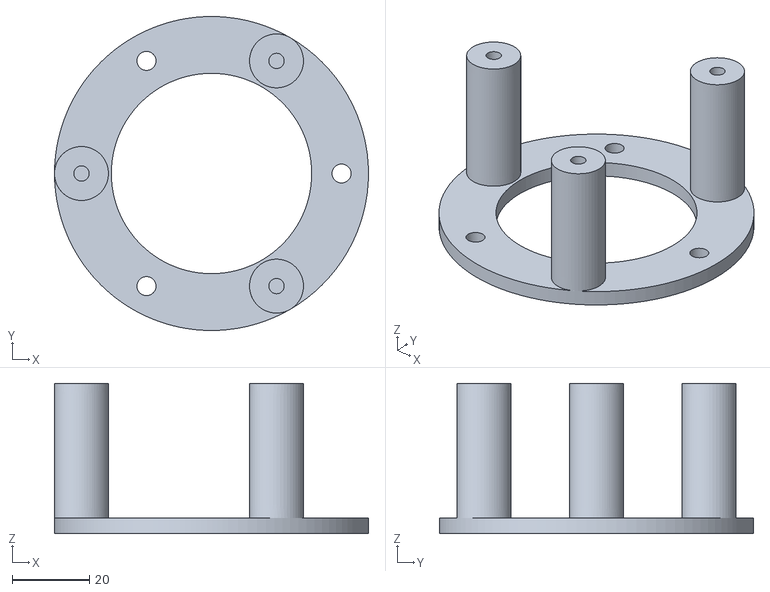
[picture p44: CAD file, 2026-11-05]
exports/stl/hip_gearbox/HG_CarrierIn.stl
81.5 x 81.5 x 39.0
