joengineer656/test-claude-in-mechanical-design/exports/stl/leg/shank.stl

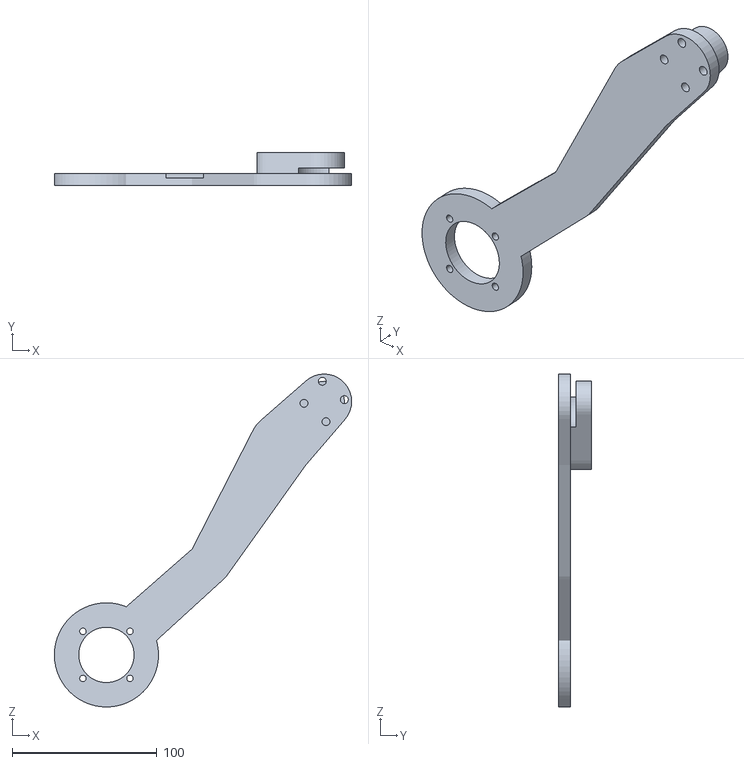
[picture p45: CAD file, 2026-11-05]
exports/stl/leg/shank.stl
205.5 x 22.5 x 230.1
