joengineer656/test-claude-in-mechanical-design/exports/stl/wheel/tyre.stl

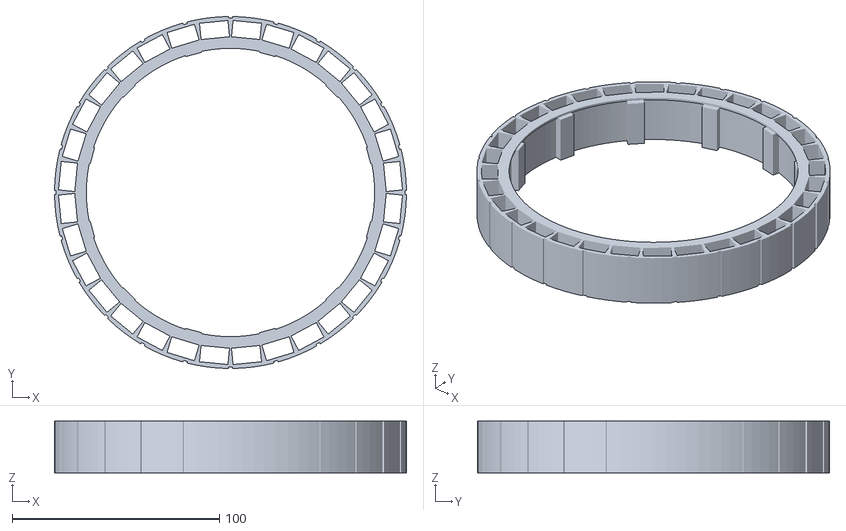
[picture p46: CAD file, 2026-11-05]
exports/stl/wheel/tyre.stl
170.0 x 170.0 x 25.0
