joengineer656/test-claude-in-mechanical-design/exports/step/wheel_cover.step

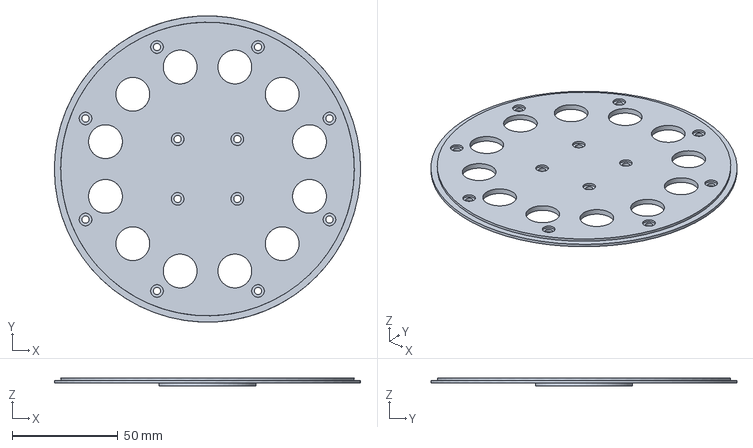
[picture p47: CAD file, 2026-11-05]
exports/step/wheel_cover.step
145.0 x 144.9 x 4.00 mm
