joengineer656/test-claude-in-mechanical-design/exports/stl/body/B3_Lid.stl

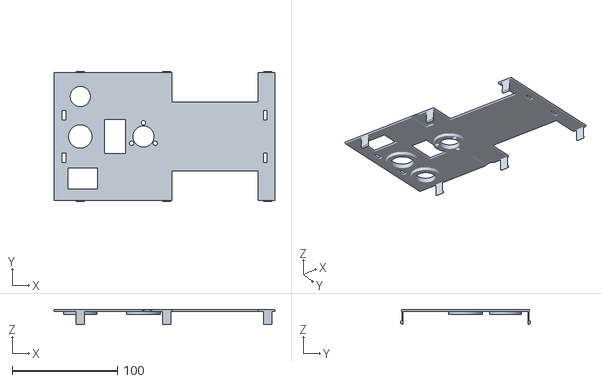
[picture p48: CAD file, 2026-11-05]
exports/stl/body/B3_Lid.stl
210.0 x 123.2 x 14.0
