joengineer656/test-claude-in-mechanical-design/exports/stl/hip_gearbox/HG_Sun.stl

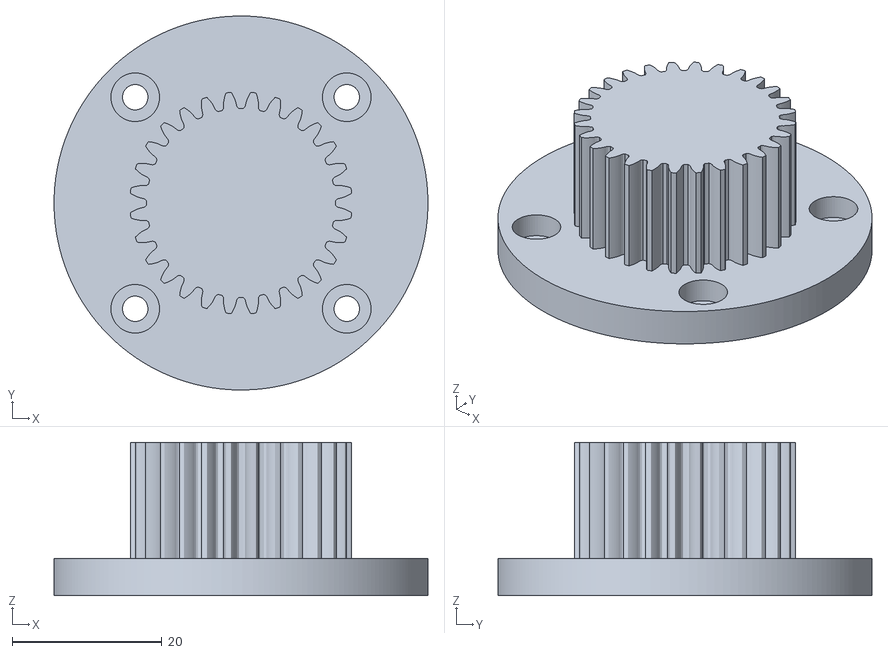
[picture p49: CAD file, 2026-11-05]
exports/stl/hip_gearbox/HG_Sun.stl
50.0 x 50.0 x 20.5
