joengineer656/test-claude-in-mechanical-design/exports/stl/leg/arch.stl

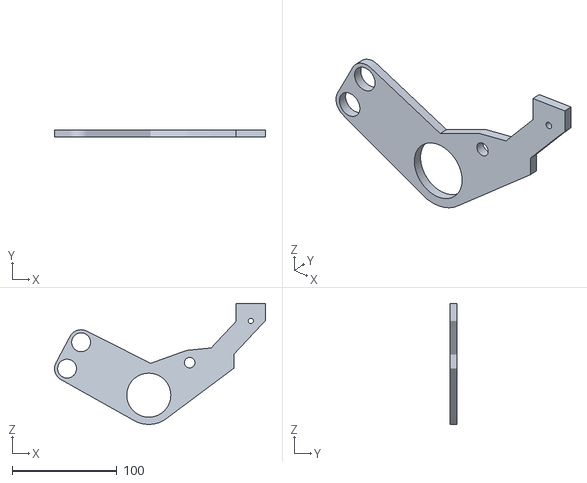
[picture p50: CAD file, 2026-11-05]
exports/stl/leg/arch.stl
201.4 x 7.00 x 115.5
