joengineer656/test-claude-in-mechanical-design/exports/stl/wheel/hub.stl

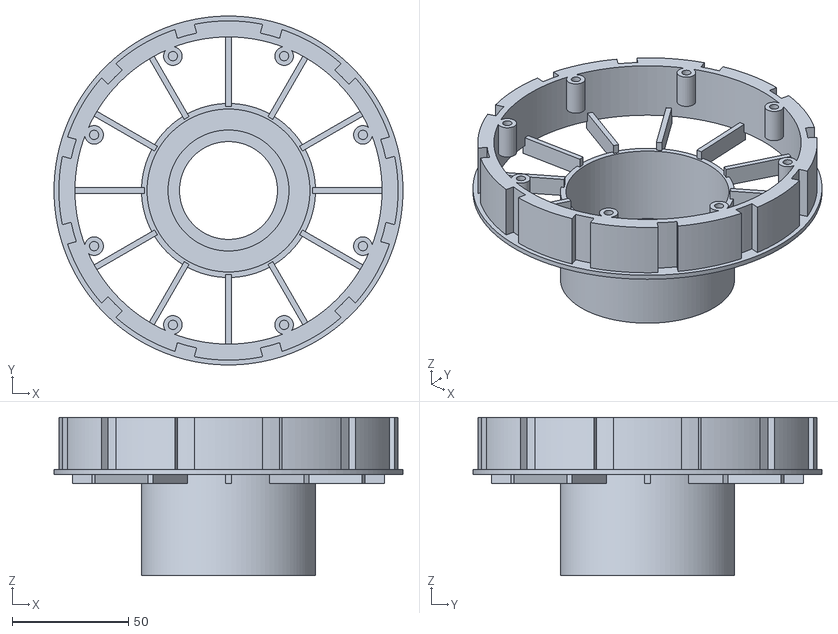
[picture p51: CAD file, 2026-11-05]
exports/stl/wheel/hub.stl
150.0 x 150.0 x 68.0
