joengineer656/test-claude-in-mechanical-design/exports/stl/hip_gearbox/HG_Cover_L.stl

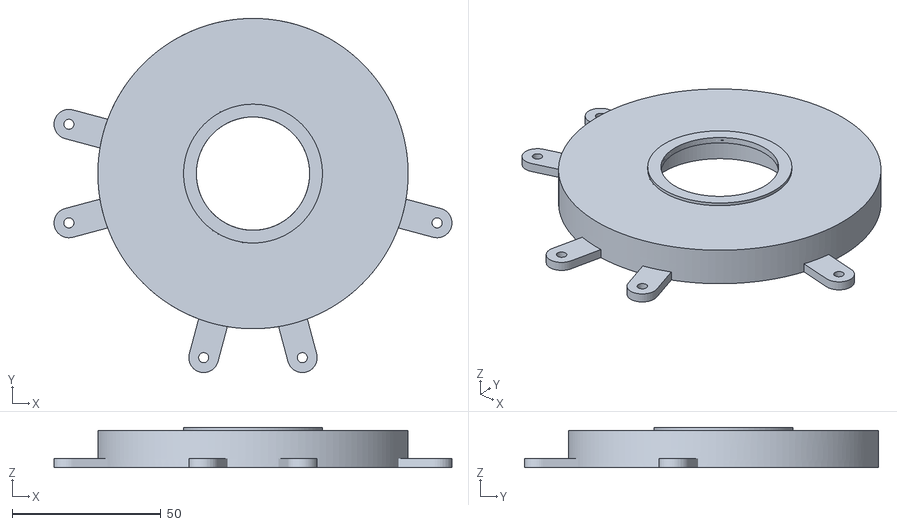
[picture p52: CAD file, 2026-11-05]
exports/stl/hip_gearbox/HG_Cover_L.stl
133.6 x 118.9 x 13.5
