joengineer656/test-claude-in-mechanical-design/exports/stl/leg/cstand.stl

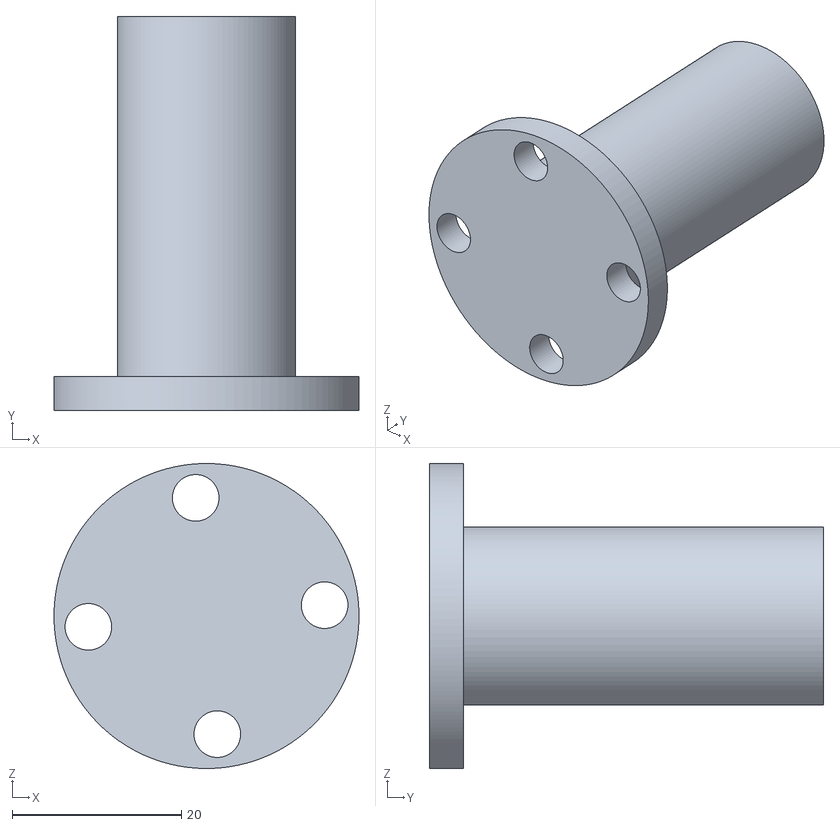
[picture p53: CAD file, 2026-11-05]
exports/stl/leg/cstand.stl
36.0 x 46.5 x 36.0
