joengineer656/test-claude-in-mechanical-design/exports/stl/wheel/planets.stl

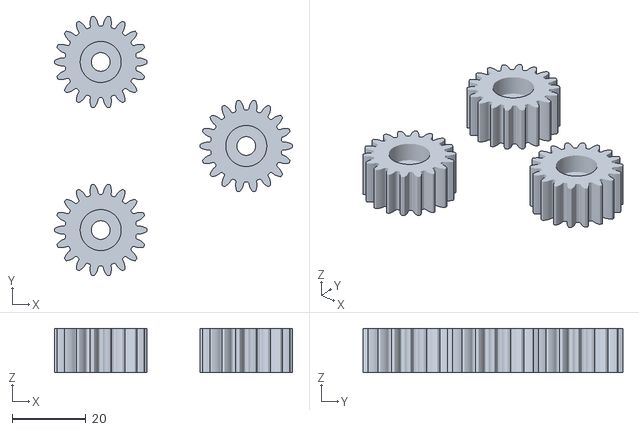
[picture p54: CAD file, 2026-11-05]
exports/stl/wheel/planets.stl
64.4 x 70.2 x 12.0
