joengineer656/test-claude-in-mechanical-design/exports/step/wheel_carrierA.step

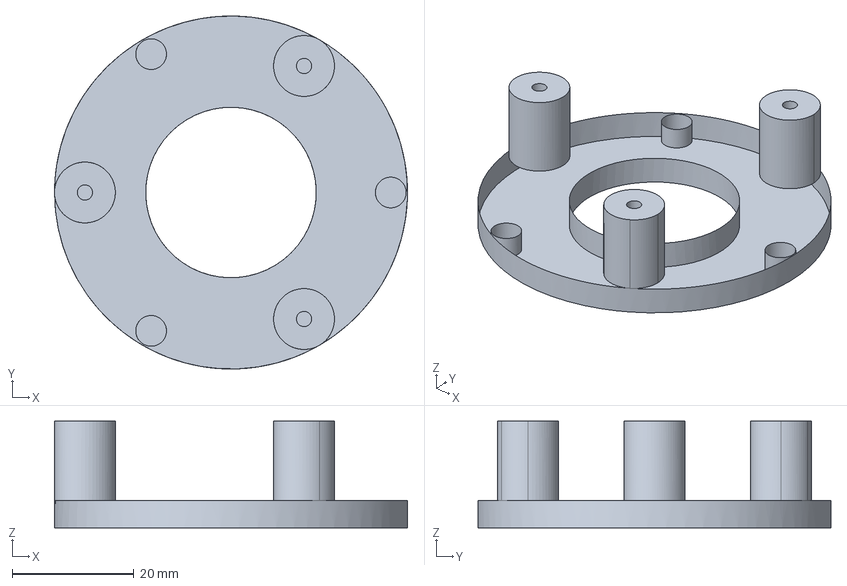
[picture p55: CAD file, 2026-11-05]
exports/step/wheel_carrierA.step
58.0 x 58.0 x 17.5 mm
