joengineer656/test-claude-in-mechanical-design/exports/stl/body/B1_Side_L.stl

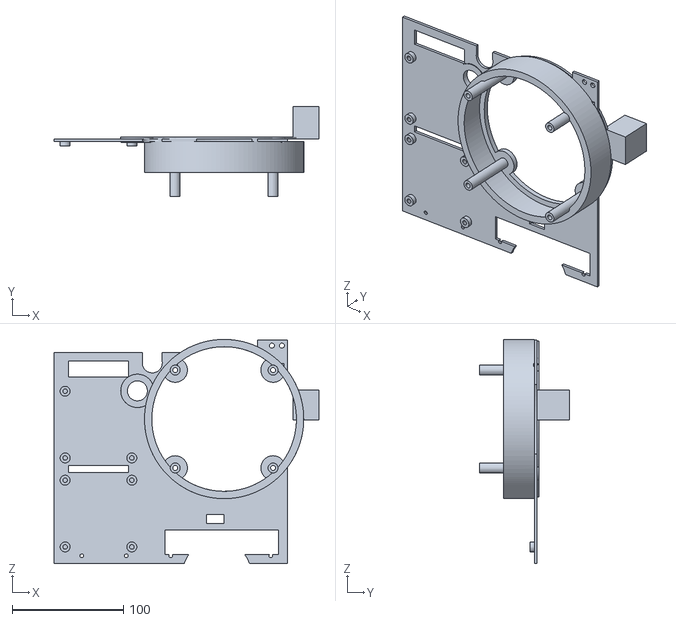
[picture p56: CAD file, 2026-11-05]
exports/stl/body/B1_Side_L.stl
238.3 x 80.5 x 201.6
