joengineer656/test-claude-in-mechanical-design/exports/stl/leg/strap.stl

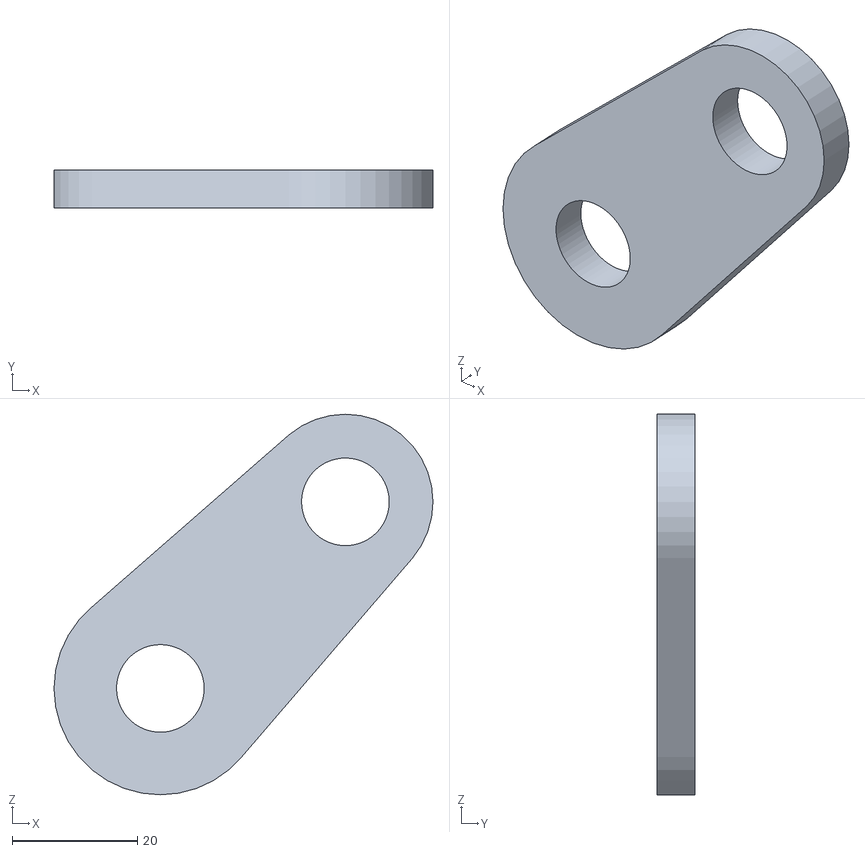
[picture p57: CAD file, 2026-11-05]
exports/stl/leg/strap.stl
60.6 x 6.00 x 60.8
