joengineer656/test-claude-in-mechanical-design/exports/stl/wheel/ringsleeve.stl

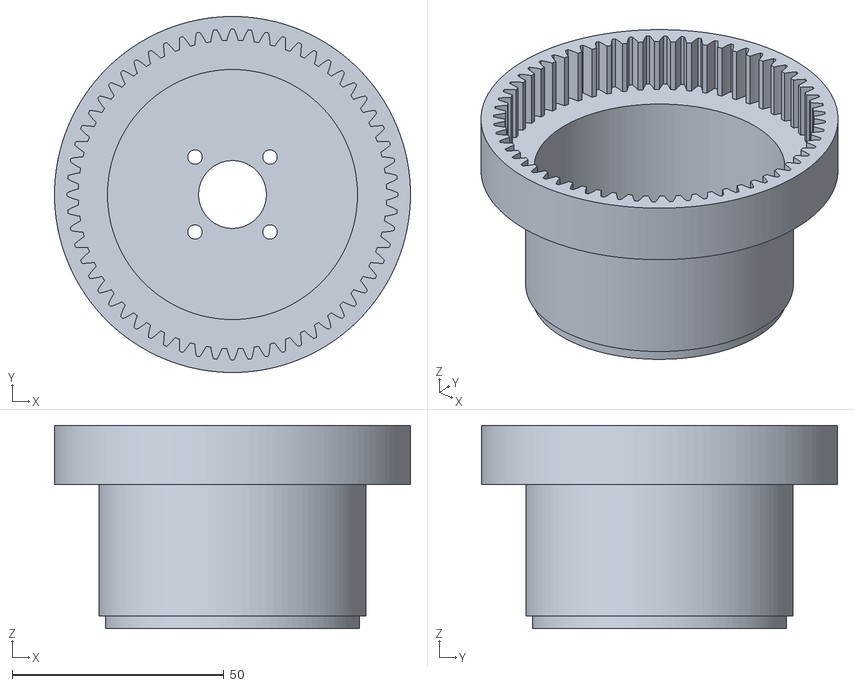
[picture p58: CAD file, 2026-11-05]
exports/stl/wheel/ringsleeve.stl
84.0 x 84.0 x 48.0
