joengineer656/test-claude-in-mechanical-design/exports/stl/body/B5_Rear.stl

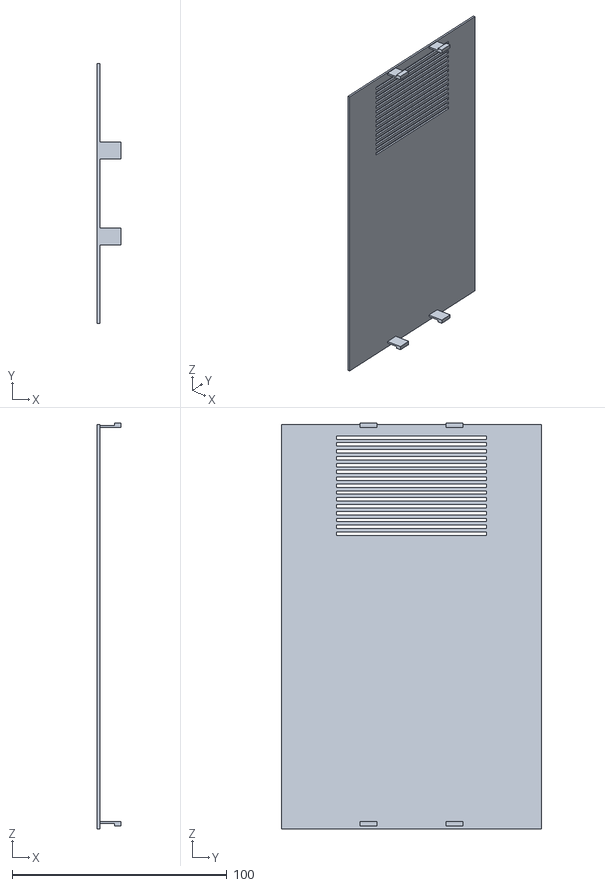
[picture p59: CAD file, 2026-11-05]
exports/stl/body/B5_Rear.stl
11.0 x 121.2 x 189.2
