joengineer656/test-claude-in-mechanical-design/exports/step/wheel_sun.step

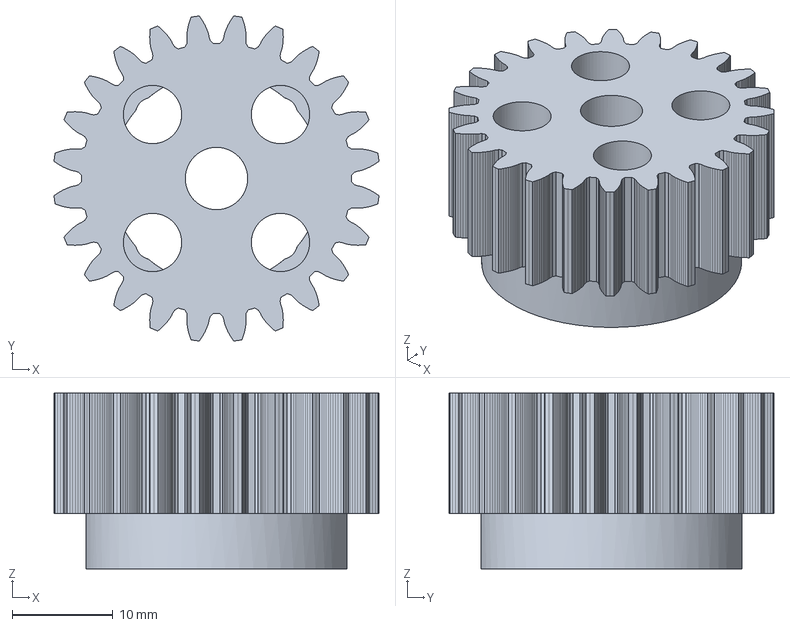
[picture p60: CAD file, 2026-11-05]
exports/step/wheel_sun.step
32.3 x 32.3 x 17.5 mm
