joengineer656/test-claude-in-mechanical-design/exports/stl/body/B2_Tray.stl

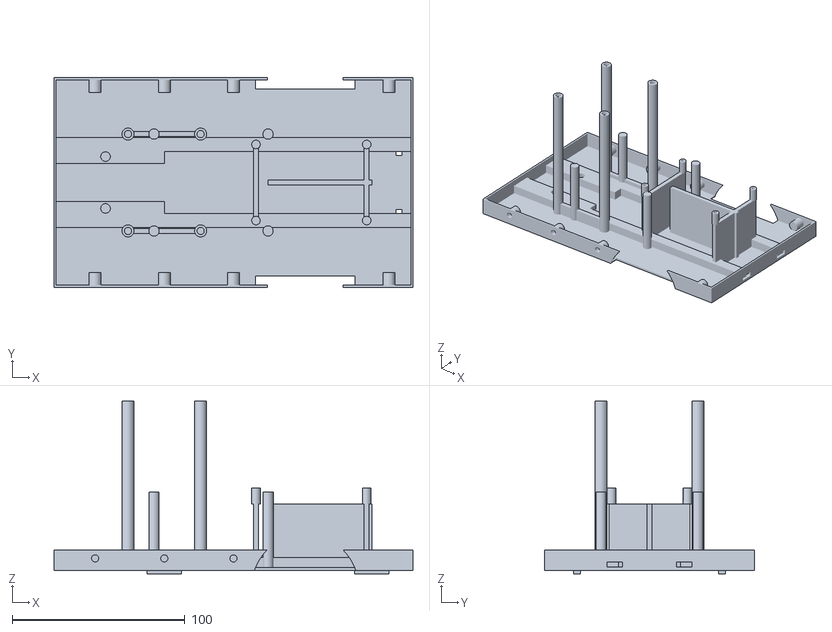
[picture p61: CAD file, 2026-11-05]
exports/stl/body/B2_Tray.stl
207.6 x 121.2 x 100.0
