joengineer656/test-claude-in-mechanical-design/exports/stl/leg/hw.stl

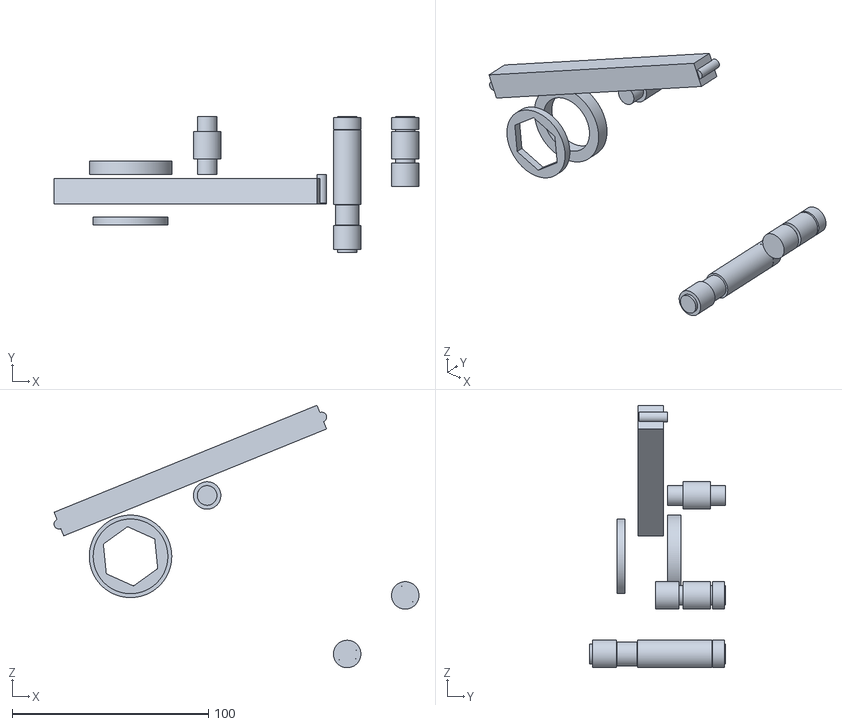
[picture p62: CAD file, 2026-11-05]
exports/stl/leg/hw.stl
185.9 x 69.0 x 133.6
