joengineer656/test-claude-in-mechanical-design/exports/stl/wheel/sun.stl

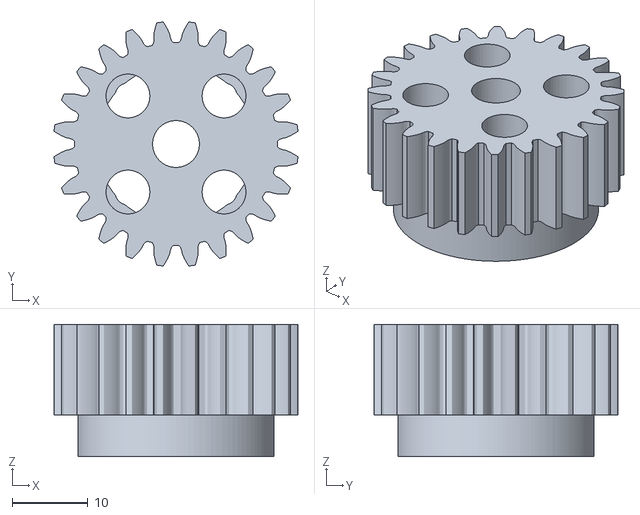
[picture p63: CAD file, 2026-11-05]
exports/stl/wheel/sun.stl
32.3 x 32.3 x 17.5
