joengineer656/test-claude-in-mechanical-design/exports/step/leg_beam.step

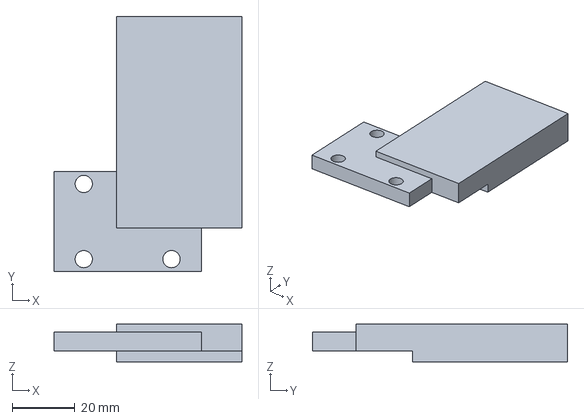
[picture p64: CAD file, 2026-11-05]
exports/step/leg_beam.step
60.0 x 81.5 x 12.0 mm
