joengineer656/test-claude-in-mechanical-design/exports/stl/body/B2b_Cradle.stl

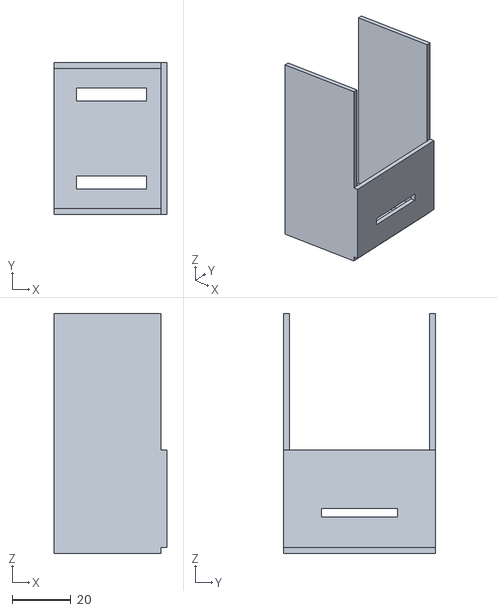
[picture p65: CAD file, 2026-11-05]
exports/stl/body/B2b_Cradle.stl
38.6 x 52.0 x 82.0
