joengineer656/test-claude-in-mechanical-design/exports/stl/leg/tpu.stl

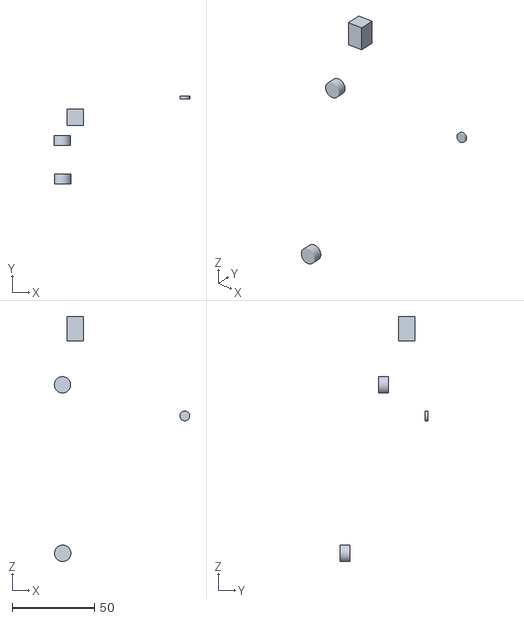
[picture p66: CAD file, 2026-11-05]
exports/stl/leg/tpu.stl
82.5 x 53.4 x 149.2
