joengineer656/test-claude-in-mechanical-design/exports/step/master_layout.step

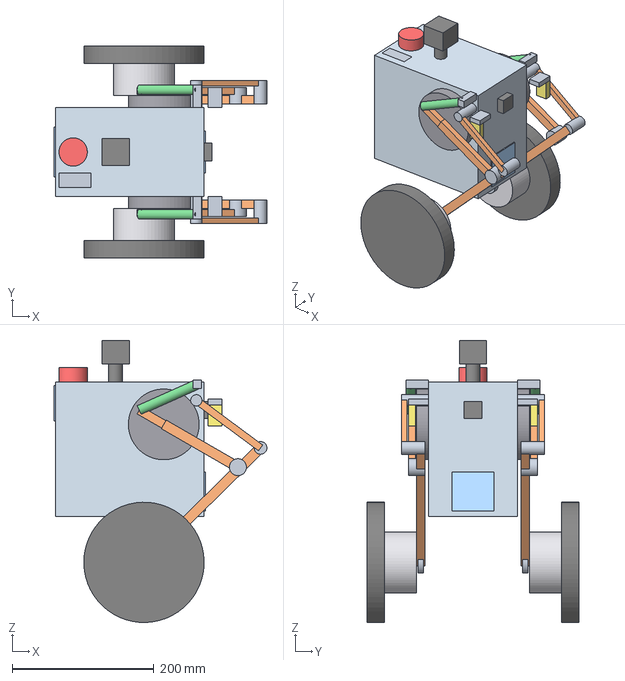
[picture p67: CAD file, 2026-11-05]
exports/step/master_layout.step
300.8 x 300.0 x 398.5 mm
