joengineer656/test-claude-in-mechanical-design/exports/step/wheel_planets.step

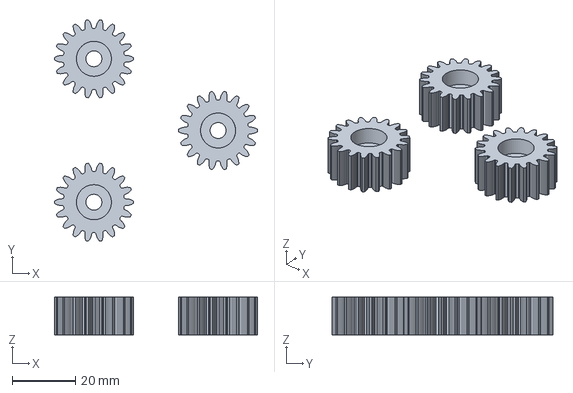
[picture p68: CAD file, 2026-11-05]
exports/step/wheel_planets.step
64.4 x 70.2 x 12.0 mm
