joengineer656/test-claude-in-mechanical-design/exports/step/wheel.step

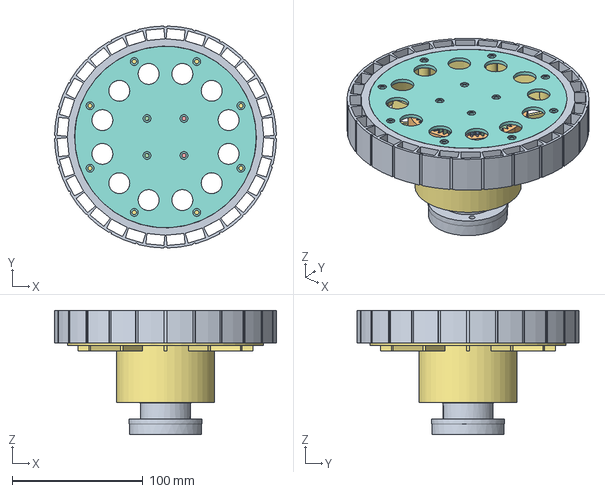
[picture p69: CAD file, 2026-11-05]
exports/step/wheel.step
170.0 x 170.0 x 95.0 mm
