joengineer656/test-claude-in-mechanical-design/exports/step/leg_shank.step

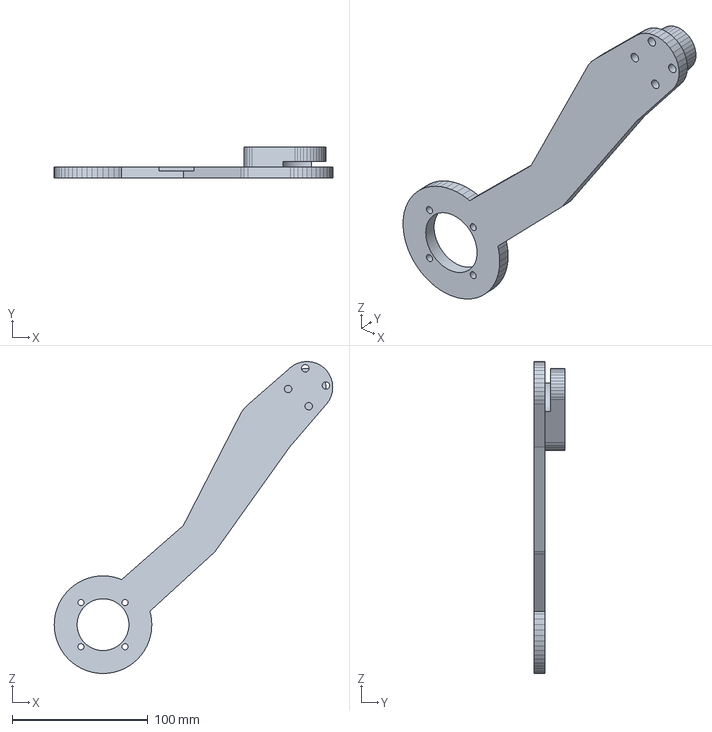
[picture p70: CAD file, 2026-11-05]
exports/step/leg_shank.step
205.5 x 22.5 x 230.1 mm
