joengineer656/test-claude-in-mechanical-design/(list of files, cad)

Other CAD files:
exports/step/wheel_bought.step
exports/step/leg_thigh.step
exports/stl/leg/plate.stl
exports/step/leg_arch.step
exports/stl/body/B1T_Tie_L.stl
exports/step/wheel_axle.step
exports/stl/leg/coupler.stl
exports/stl/wheel/cover.stl
exports/step/wheel_tyre.step
exports/stl/leg/beam.stl
exports/step/leg_posts.step
exports/step/leg_tpu.step
exports/step/leg_strap.step
exports/step/leg_cstand.step
exports/step/wheel_carrierB.step
exports/step/leg_hw.step
exports/step/hip_gearbox.step
exports/step/wheel_ringsleeve.step
exports/step/leg_bplate.step
exports/step/wheel_hub.step
