joengineer656/test-claude-in-mechanical-design/docs/analysis/calc/com_assembly_output.txt

solid: mass 6871 g  CoM x 19.0 (vs axle +1.6), y -0.01, z 228.0 (above axle 143.0)
sliced: mass 6258 g  CoM x 17.8 (vs axle +0.4), y -0.02, z 229.4 (above axle 144.4)
{'Body+electronics': 1463, 'WH': 1259, 'Leg': 1897, 'HG': 1720, 'lumps': 532}
