joengineer656/test-claude-in-mechanical-design/docs/screenshots/assembly_top.png

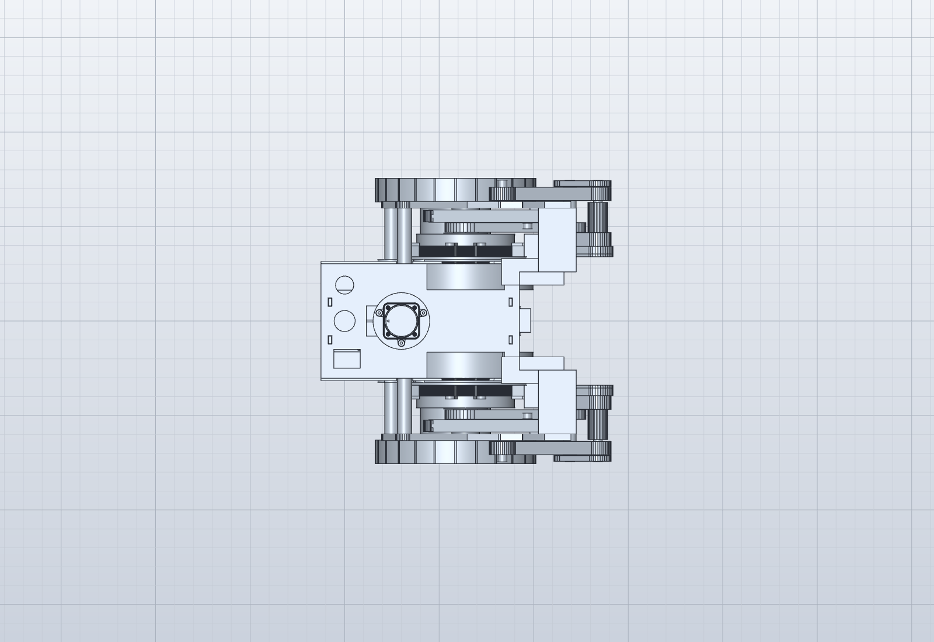
docs/screenshots/assembly_top.png
